pratikac/islom/README.md

islom
=====

Single legged hopping robot
