pratikac/islom/trunk/Doc/StageII/pres/design.tex

\section{Design}
\subsection*{Final Design}

\begin{frame}
\frametitle{Final Design}

\begin{columns}

\column{0.5\textwidth}
\begin{figure}
\centering
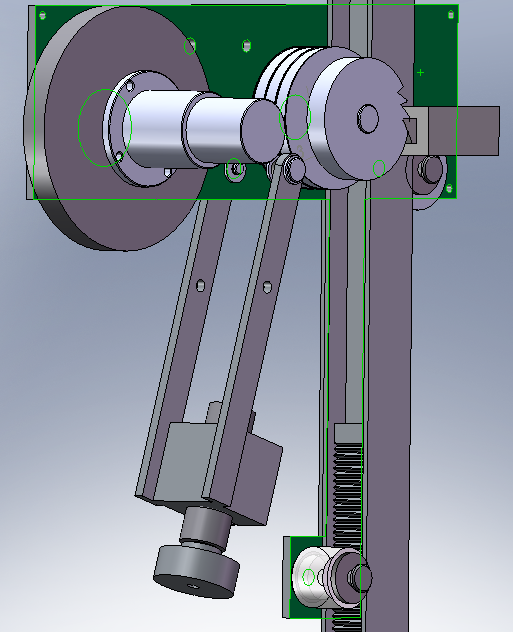
[picture p2: trunk/Doc/StageII/pres/fig/hopper_detach.png]

\caption{Detached motor sleeve}
\end{figure}

\column{0.5\textwidth}
\begin{block}{Features}
\begin{itemize}
\item
{\greencol EPM :}\\[0.1in]
    \begin{itemize}
    \item
    Motor travels down on rack\\[0.1in]
    \item
    Dual springs, helical gears and slant rack\\[0.1in]
    \end{itemize}
\item
{\greencol Constraint :}\\[0.1in]
    \begin{itemize}
    \item
    Ratchet and Paul\\[0.1in]
    \item
    Band drive\\[0.1in]
    \item
    Disengage motor sleeve\\[0.1in]
    \end{itemize}
\end{itemize}
\end{block}
\end{columns}
\end{frame}

\begin{frame}
\begin{columns}
\column{0.5\textwidth}
\begin{figure}
\centering

\caption{Detached motor sleeve}
\end{figure}

\column{0.5\textwidth}
\begin{figure}
\centering
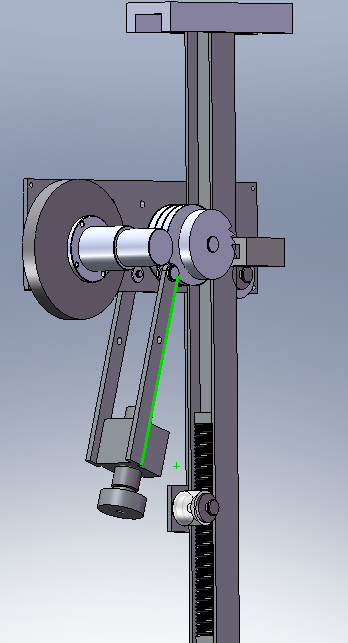
[picture p3: trunk/Doc/StageII/pres/fig/hopper_bot.png]

\caption{Full Robot}
\end{figure}
\end{columns}
\end{frame}

\begin{frame}
\frametitle{Final Design}
\begin{columns}

\column{0.5\textwidth}
\begin{figure}
\centering
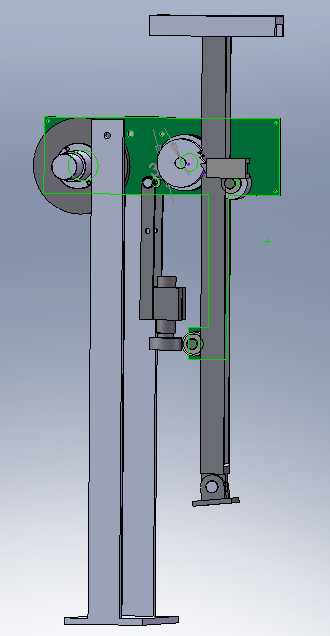
[picture p4: trunk/Doc/StageII/pres/fig/hopper_iso.png]

\caption{Test Rig}
\end{figure}

\column{0.5\textwidth}
\begin{block}{Features}
\begin{itemize}
\item
{\greencol Test-rig :}\\[0.1in]
    \begin{itemize}
    \item
    Pivoted near the C.G.\\[0.1in]
    \item
    Attitude re--orientation\\[0.1in]
    \item
    Simulated hopping\\[0.1in]
    \end{itemize}
\item
{\greencol Overall :}\\[0.1in]
    \begin{itemize}
    \item
    Height : $\sim$ 500 mm\\[0.1in]
    \item
    Leg $\sim$ 0.7 kg\\[0.1in]
    \item
    Total $\sim$ 4.7 kg\\[0.1in]
    \item
    Disengage motor sleeve\\[0.1in]
    \end{itemize}
\end{itemize}
\end{block}
\end{columns}
\end{frame}
