pratikac/islom/trunk/Doc/StageII/report/appendix.tex

{
\appendix
\chapter{Equations of motion}
\lstinputlisting{eqns.m}

\chapter{Kalman Filter Implementation}
\lstinputlisting{kalman_code.c}

}
