pratikac/islom/trunk/Doc/StageII/pres/conclu.tex

\section{Conclusion}

\begin{frame}
\frametitle{Summary}
\begin{block}{Fabrication}
\begin{itemize}
  \item 
  Robot fabrication almost done\\[0.1in]
  \item
  Electronics ready\\[0.1in]
\end{itemize} 
\end{block}\\[0.2in]

\begin{block}{Controller}
\begin{itemize}
  \item 
  In-place hopping solved\\[0.1in]
  \item
  More work on trajectory following\\[0.1in]
\end{itemize} 
\end{block}\\[0.2in]

\begin{block}{Future Work}
\begin{itemize}
  \item 
  Assisted test-rig control\\[0.1in]
  \item
  Running on treadmill
\end{itemize} 
\end{block}
\end{frame}
