pratikac/islom/trunk/Doc/StageII/report/fig/line_sketch.pdf

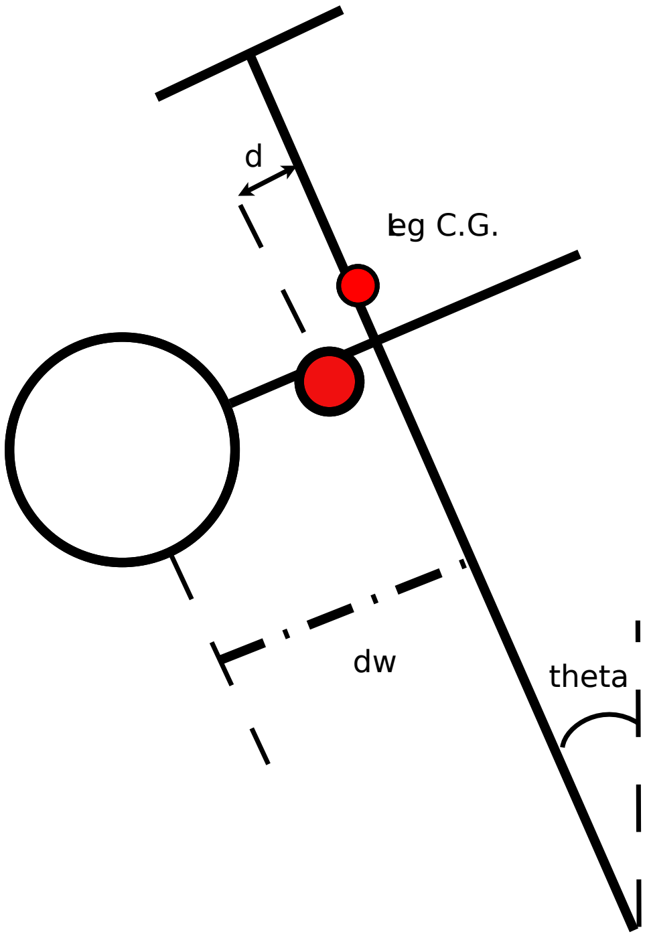
[picture p40: figure]
theta; Leg C.G.
