pratikac/islom/trunk/Doc/StageI/report/fig/freq_m.pdf

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

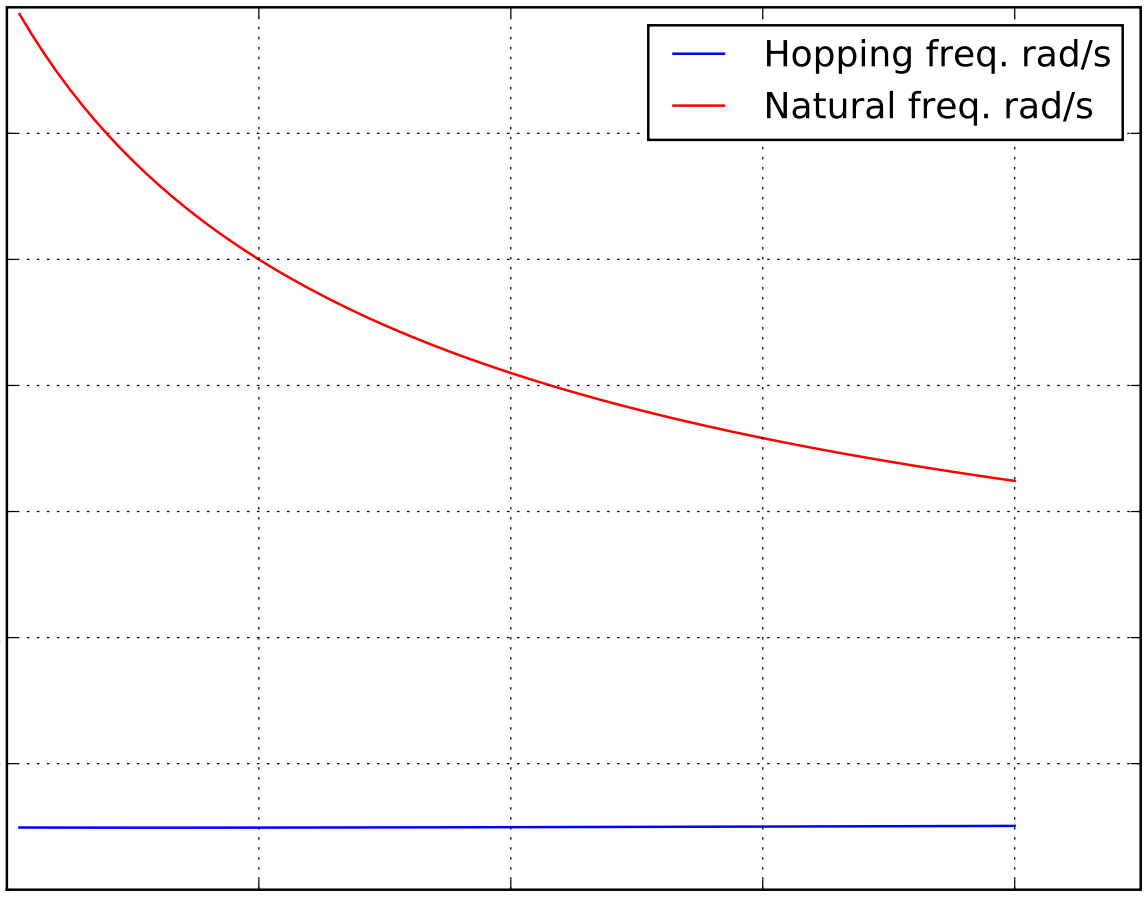
[picture p41: figure]
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
