pratikac/islom/trunk/Doc/StageI/report/fig/Rai_2D.pdf

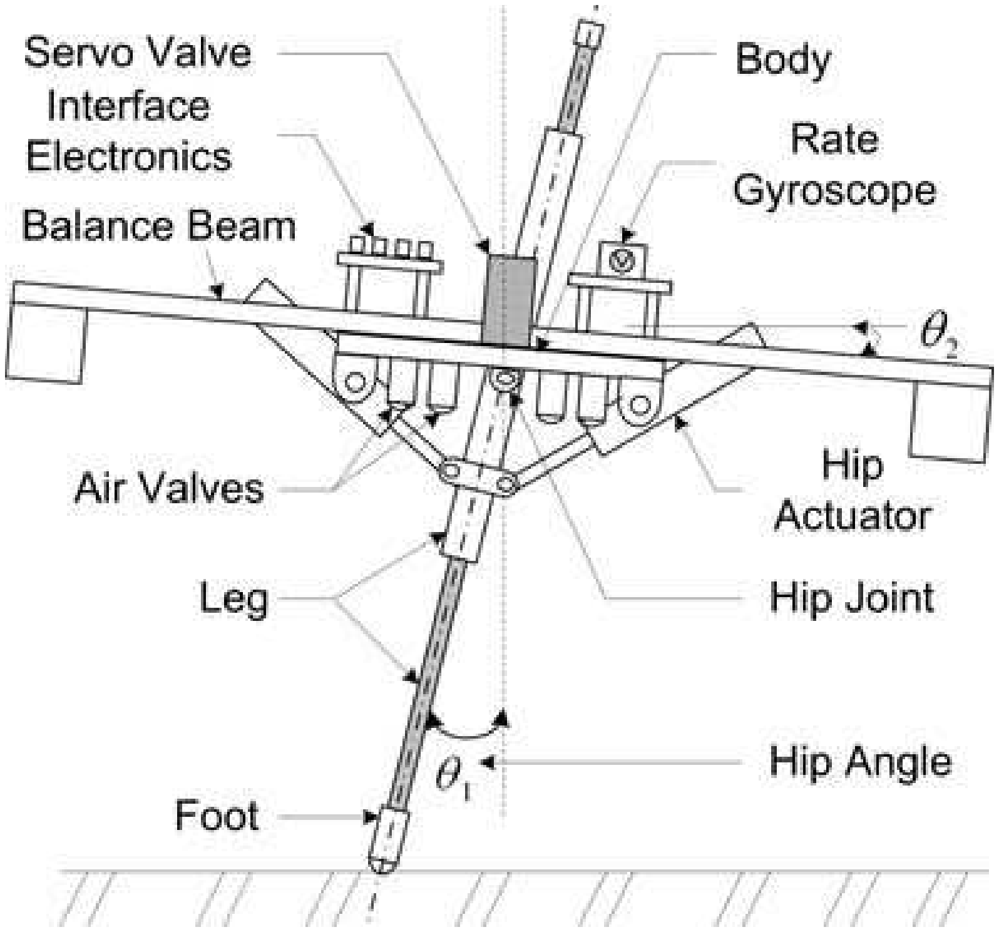
[picture p42: page 1]
