pratikac/islom/trunk/Doc/StageI/report/fig/Rai_3D.pdf

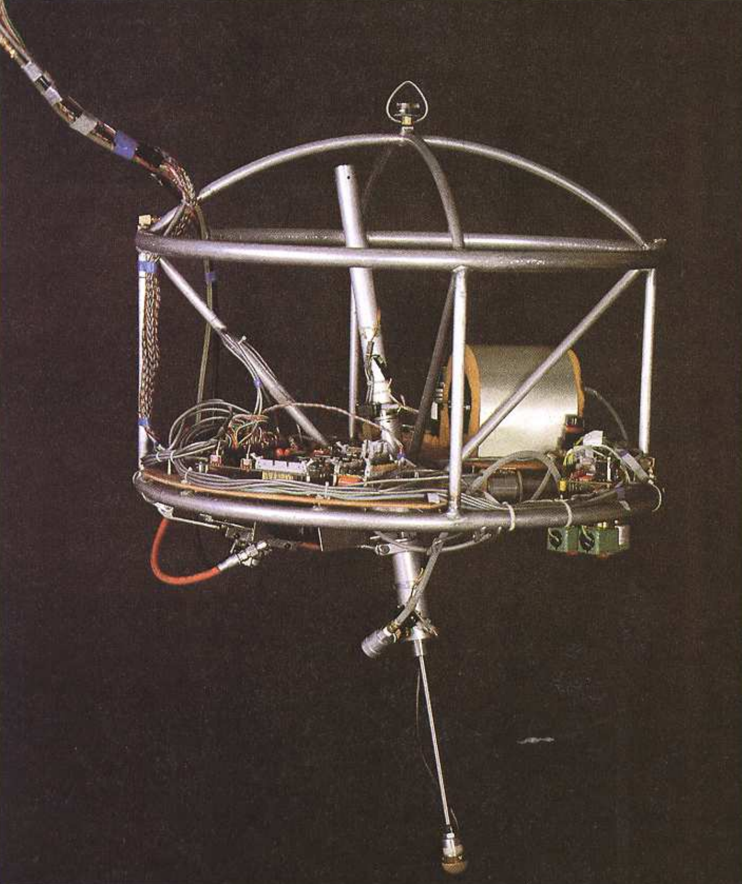
[picture p43: page 1]
