pratikac/islom/trunk/Doc/StageII/report/fig/atanD.pdf

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

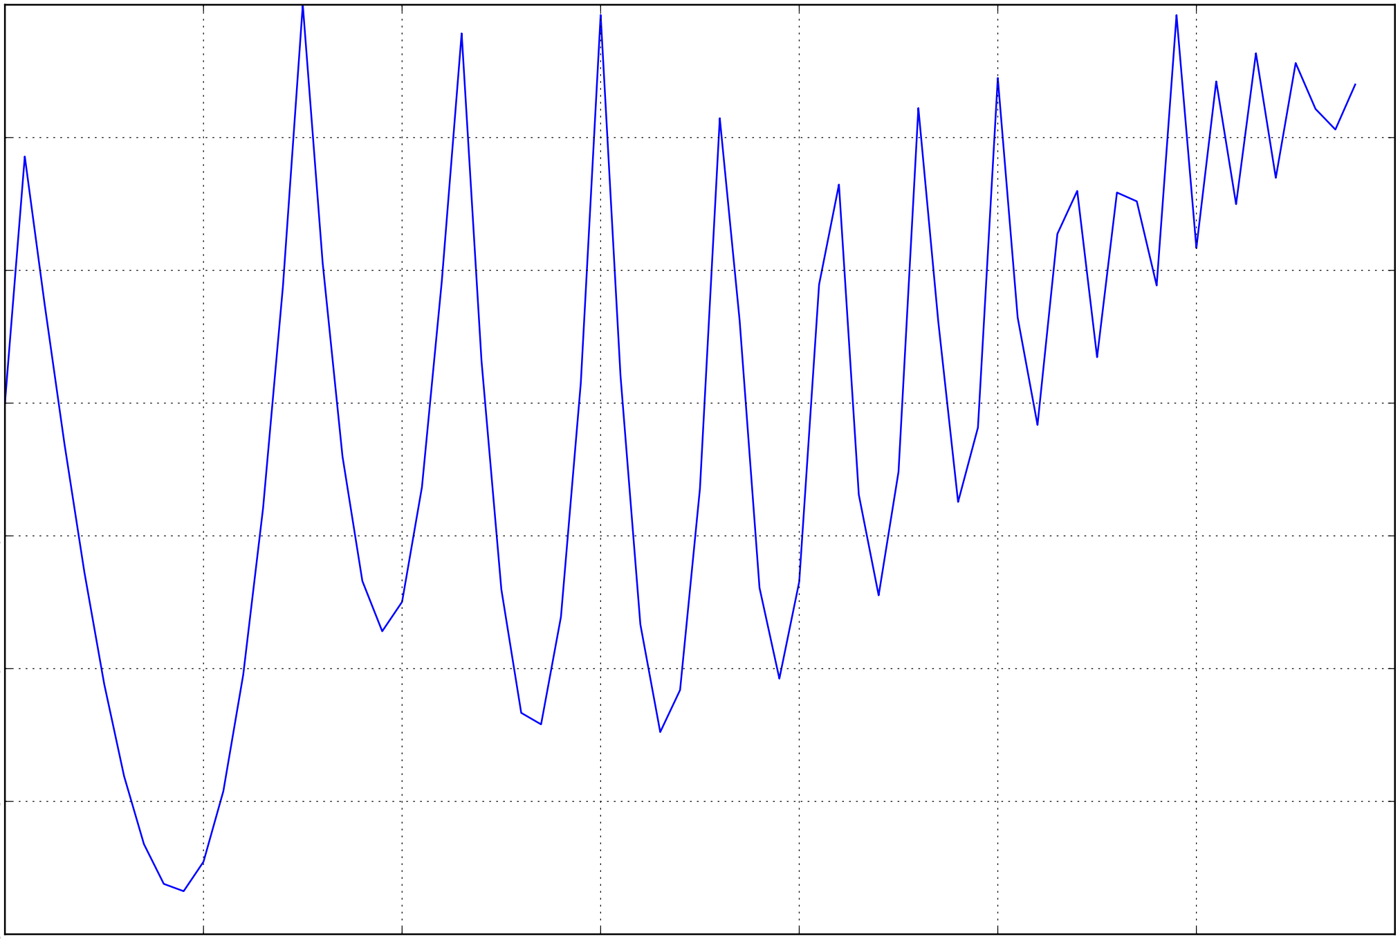
[picture p44: figure]
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
