pratikac/islom/trunk/Doc/StageI/pres/fig/cartoon.png

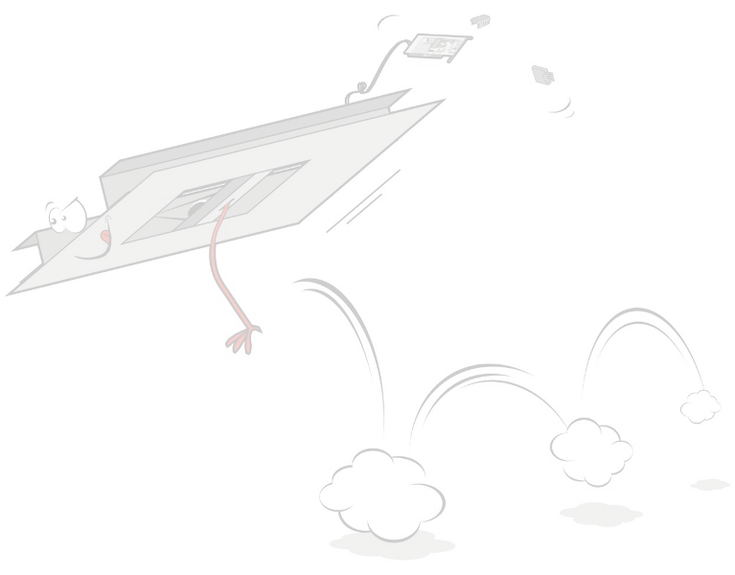
trunk/Doc/StageI/pres/fig/cartoon.png
