pratikac/islom/trunk/SolidWorks/gear_pulley.png

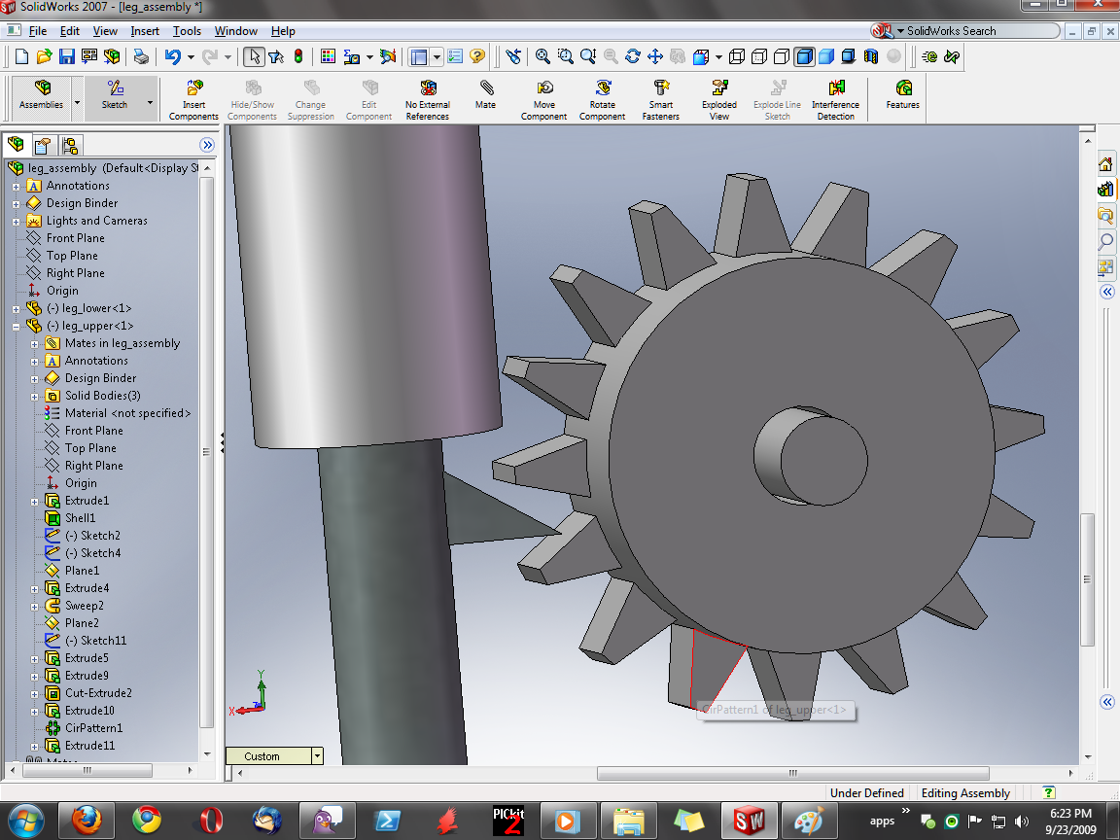
trunk/SolidWorks/gear_pulley.png
