pratikac/islom/trunk/SolidWorks/leg_assembly.SLDASM

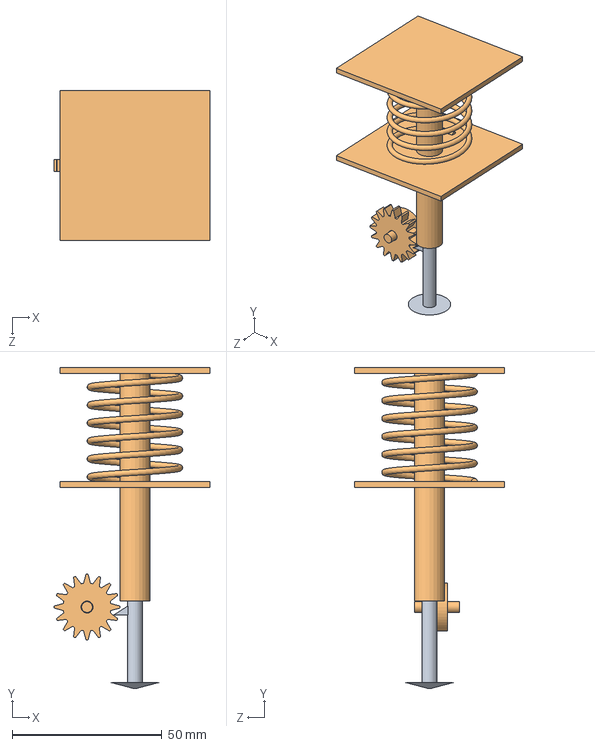
[picture p47: CAD file, 2013-02-24]
trunk/SolidWorks/leg_assembly.SLDASM
52.0 x 107.2 x 50.0 mm
leg_lower
leg_upper
