pratikac/islom/trunk/SolidWorks/fab3/platform.SLDASM

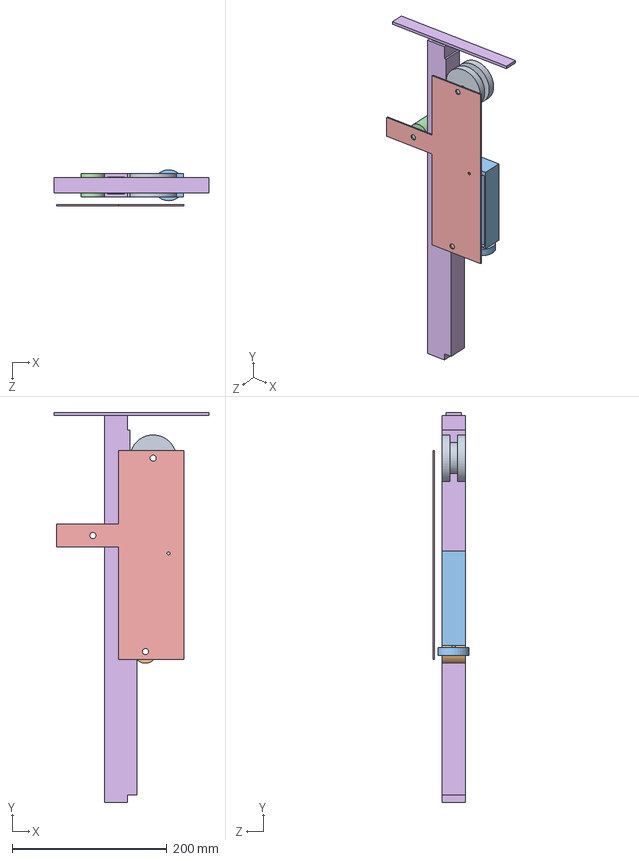
[picture p48: CAD file, 2013-02-24]
trunk/SolidWorks/fab3/platform.SLDASM
200.0 x 504.0 x 47.0 mm
band_drive
worm_wheel
motor
support_wheel
flange1
leg
