pratikac/islom/trunk/SolidWorks/Bouncebot/Bouncebot assy.SLDASM

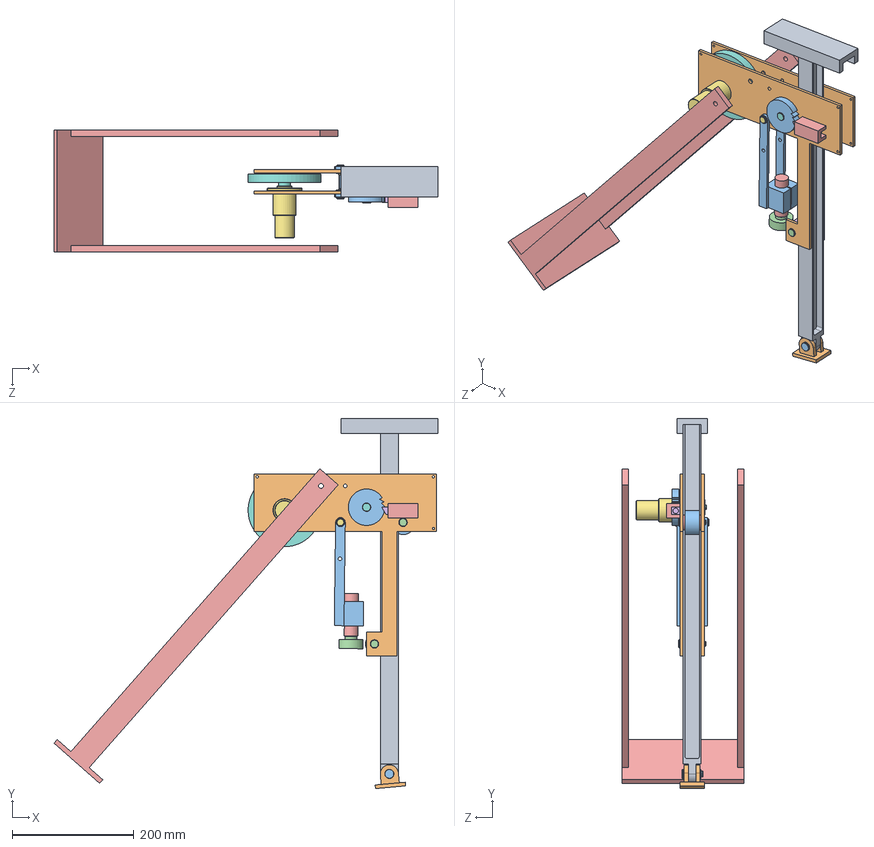
[picture p49: CAD file, 2013-02-24]
trunk/SolidWorks/Bouncebot/Bouncebot assy.SLDASM
631.8 x 609.2 x 200.0 mm
01 Stem
02 Rack
03 Swing
05 Swing Motor Gear
04 Swing Motor
06 Helical Pinion
12 Swing Pin x 2
11 Swing Pin Washer x 4
10 Swing Bush x 2
09 Slider Body x 2
13 Support Roll
08 Pinion Axle x 2
07 Pinion Spacer x 4
14 Lock Roll
18 Lock Roll Spacer x 2
19 Ratchet Pivot
16 Ratchet Key
17 Ratchet Spacer x 2
20 Ratchet
15 Lock Roll Key
22 Pawl Guide
21 Pawl
23 Rudder Roll Motor
24 Rudder Roll
25 Top Stopper
26 Stem Pivot Base
27 Stem Pivot Pin
28 Stem Pivot Spacer x 2
29 Test Stand
