pratikac/islom/trunk/SolidWorks/fab3/band_drive.SLDPRT

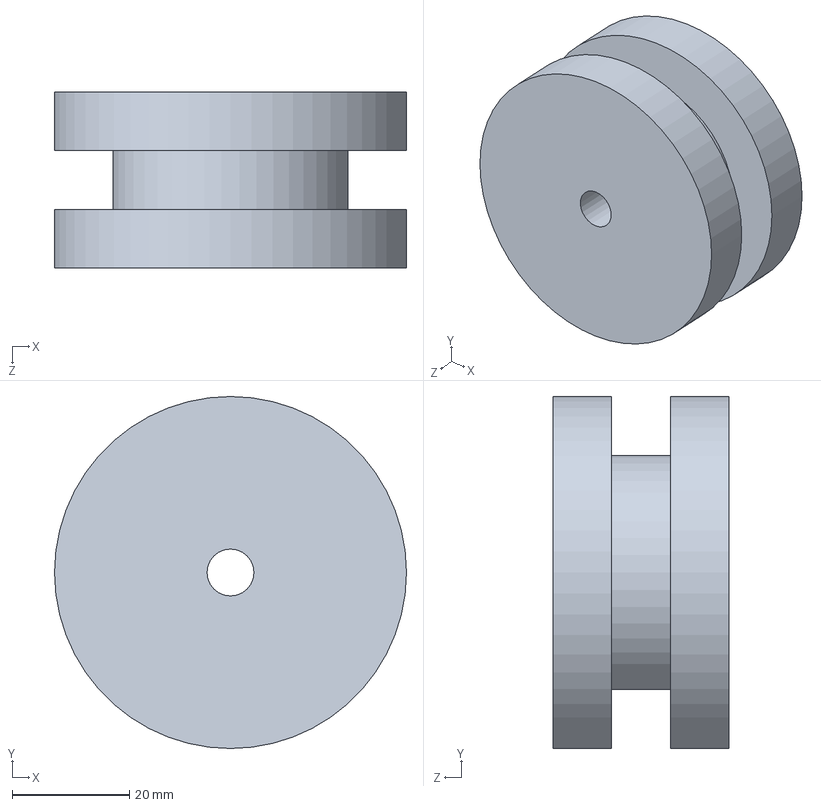
[picture p50: CAD file, 2013-02-24]
trunk/SolidWorks/fab3/band_drive.SLDPRT
60.0 x 60.0 x 30.0 mm
