pratikac/islom/trunk/SolidWorks/leg_lower.SLDPRT

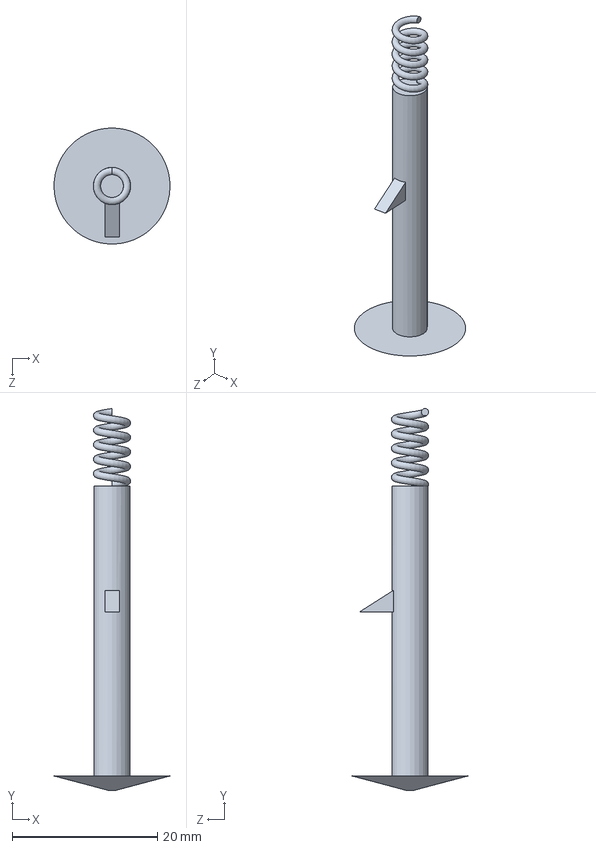
[picture p51: CAD file, 2013-02-24]
trunk/SolidWorks/leg_lower.SLDPRT
16.0 x 52.7 x 16.0 mm
