pratikac/islom/trunk/SolidWorks/Bouncebot/02 Rack.SLDPRT

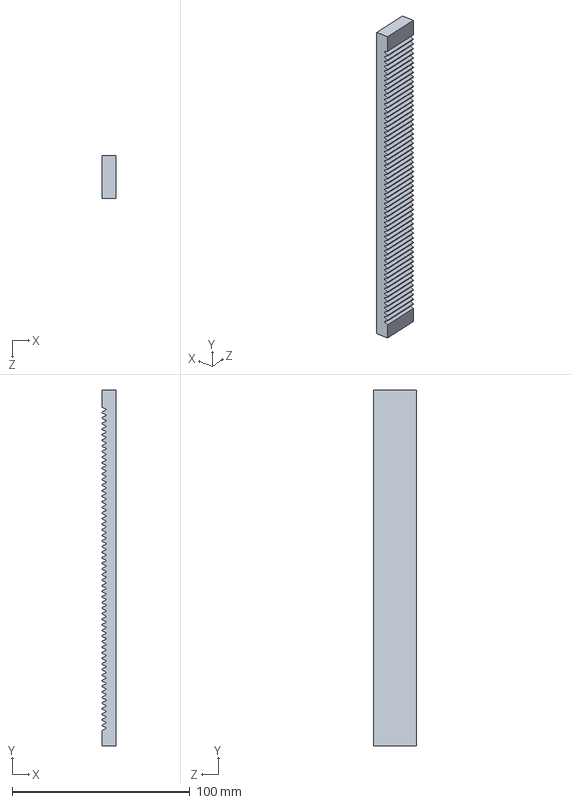
[picture p52: CAD file, 2013-02-24]
trunk/SolidWorks/Bouncebot/02 Rack.SLDPRT
8.00 x 200.0 x 24.0 mm
