pratikac/islom/trunk/SolidWorks/fab3/support_wheel.SLDPRT

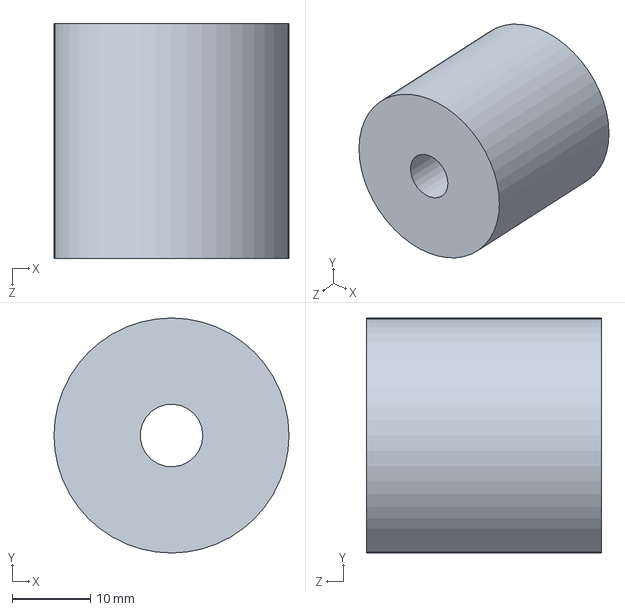
[picture p53: CAD file, 2013-02-24]
trunk/SolidWorks/fab3/support_wheel.SLDPRT
30.0 x 30.0 x 30.0 mm
