pratikac/islom/trunk/SolidWorks/fab_leg.SLDPRT

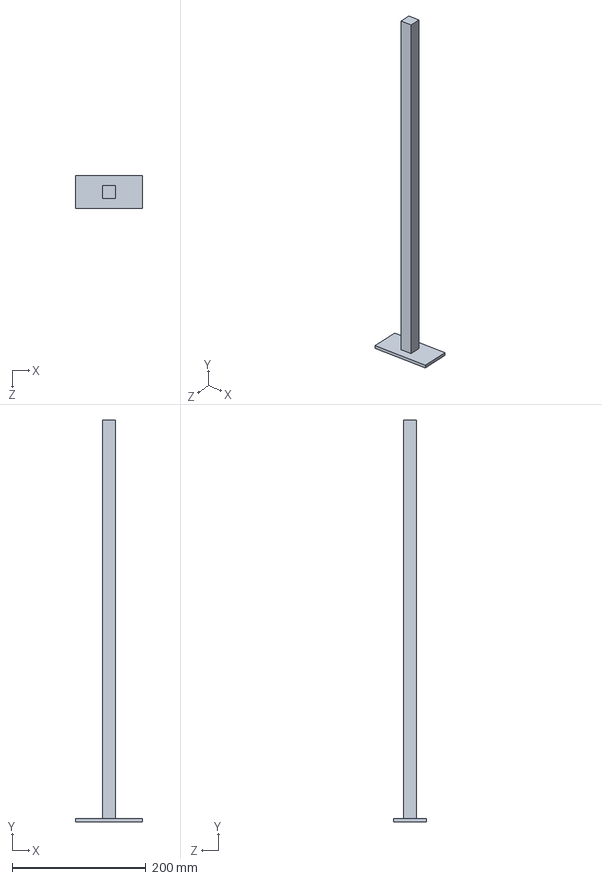
[picture p54: CAD file, 2013-02-24]
trunk/SolidWorks/fab_leg.SLDPRT
100.0 x 600.0 x 50.0 mm
