pratikac/islom/trunk/SolidWorks/Bouncebot/24 Rudder Roll.SLDPRT

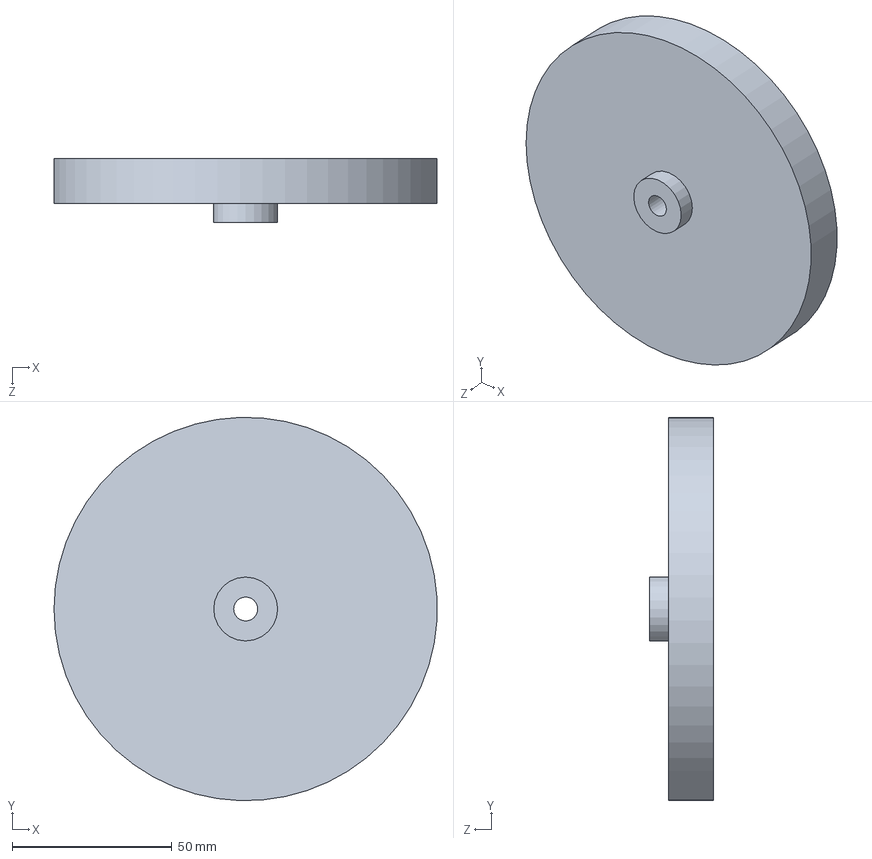
[picture p55: CAD file, 2013-02-24]
trunk/SolidWorks/Bouncebot/24 Rudder Roll.SLDPRT
119.9 x 119.9 x 20.0 mm
