pratikac/islom/trunk/SolidWorks/fab3/pin2.SLDPRT

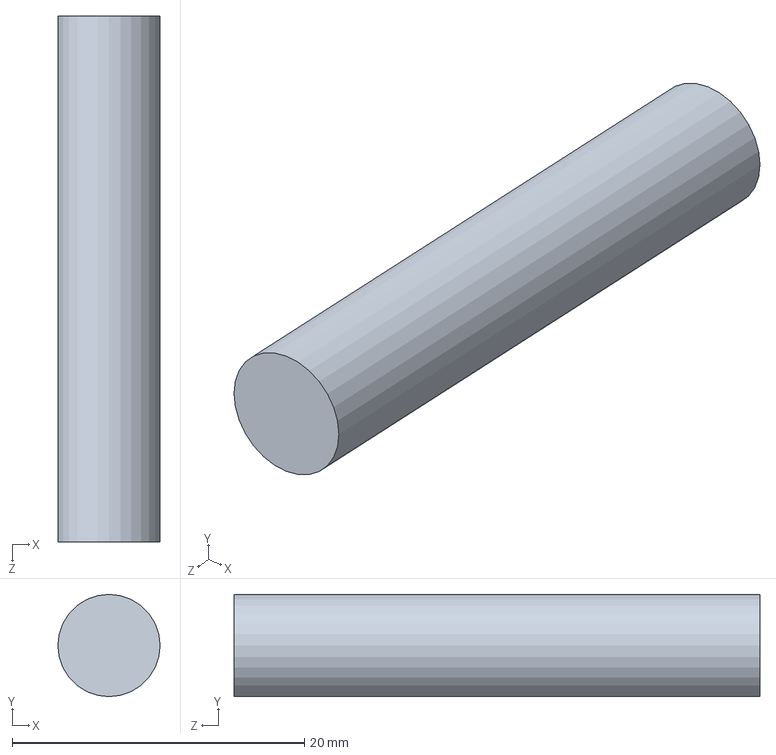
[picture p56: CAD file, 2013-02-24]
trunk/SolidWorks/fab3/pin2.SLDPRT
7.00 x 7.00 x 36.0 mm
