pratikac/islom/trunk/SolidWorks/Bouncebot/03 Swing.SLDPRT

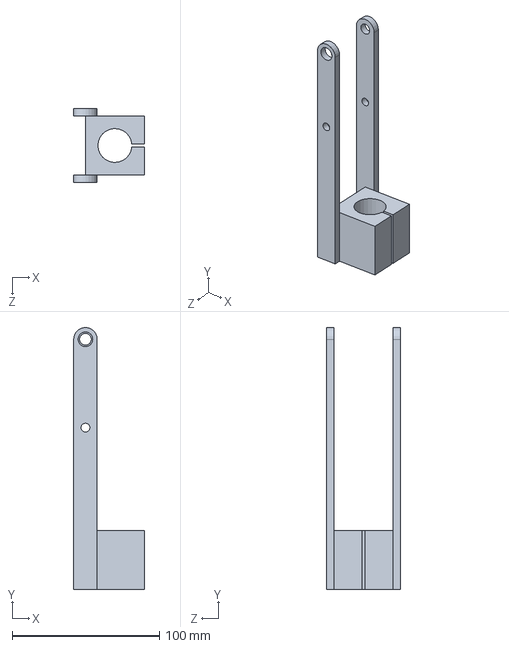
[picture p57: CAD file, 2013-02-24]
trunk/SolidWorks/Bouncebot/03 Swing.SLDPRT
48.0 x 178.0 x 50.0 mm
