pratikac/islom/trunk/SolidWorks/fab3/flange2.SLDPRT

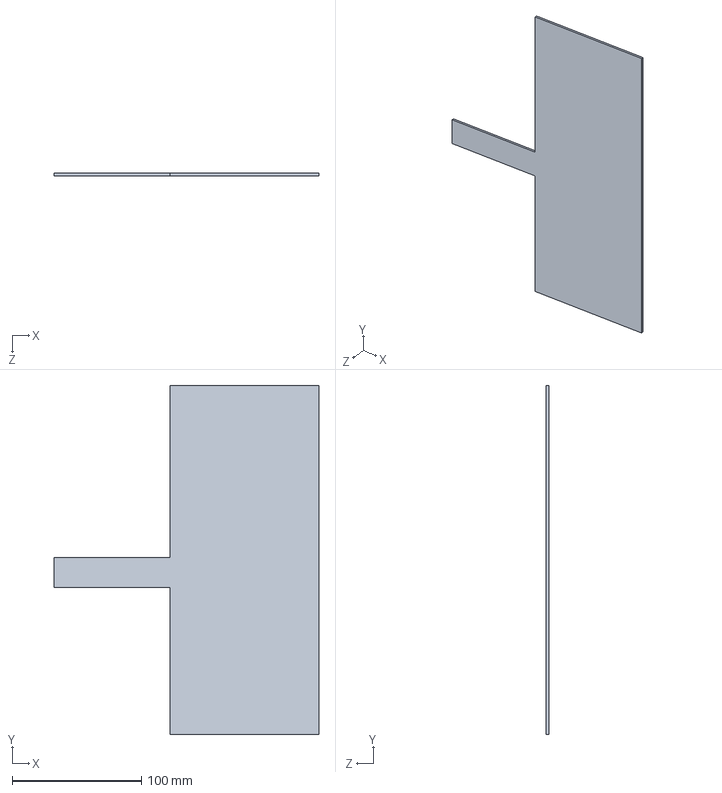
[picture p58: CAD file, 2013-02-24]
trunk/SolidWorks/fab3/flange2.SLDPRT
204.8 x 270.0 x 2.00 mm
