pratikac/islom/trunk/SolidWorks/leg_upper.SLDPRT

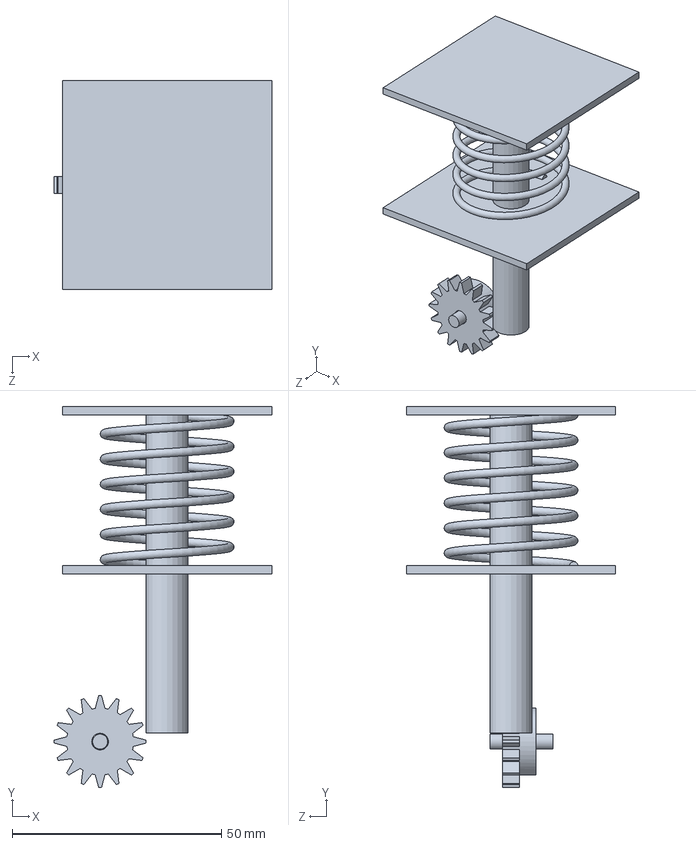
[picture p59: CAD file, 2013-02-24]
trunk/SolidWorks/leg_upper.SLDPRT
52.0 x 91.0 x 50.0 mm
