pratikac/islom/trunk/SolidWorks/Bouncebot/19 Ratchet Pivot.SLDPRT

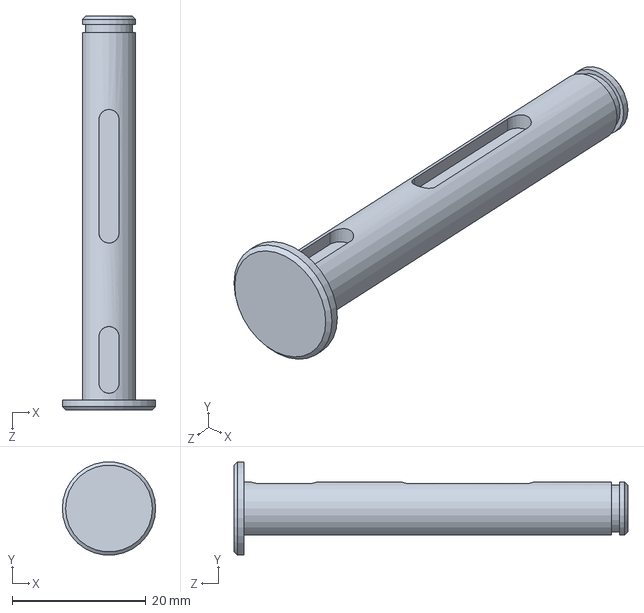
[picture p60: CAD file, 2013-02-24]
trunk/SolidWorks/Bouncebot/19 Ratchet Pivot.SLDPRT
14.0 x 13.9 x 59.0 mm
