pratikac/islom/trunk/SolidWorks/Bouncebot/29 Test Stand.SLDPRT

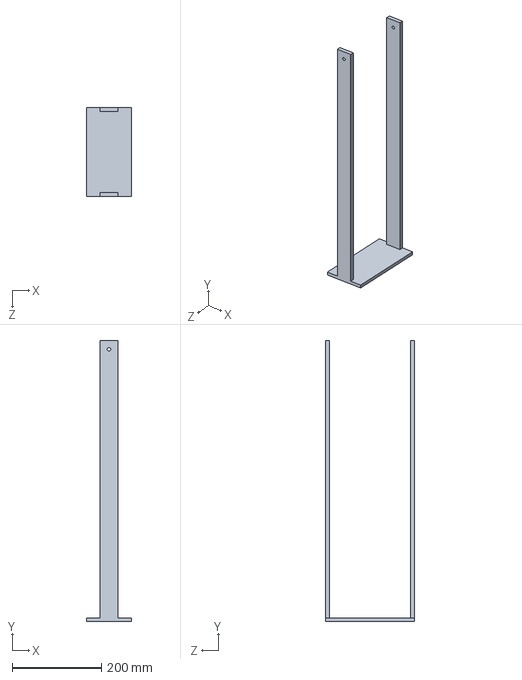
[picture p61: CAD file, 2013-02-24]
trunk/SolidWorks/Bouncebot/29 Test Stand.SLDPRT
100.0 x 628.0 x 200.0 mm
