pratikac/islom/trunk/SolidWorks/Bouncebot/25 Top Stopper.SLDPRT

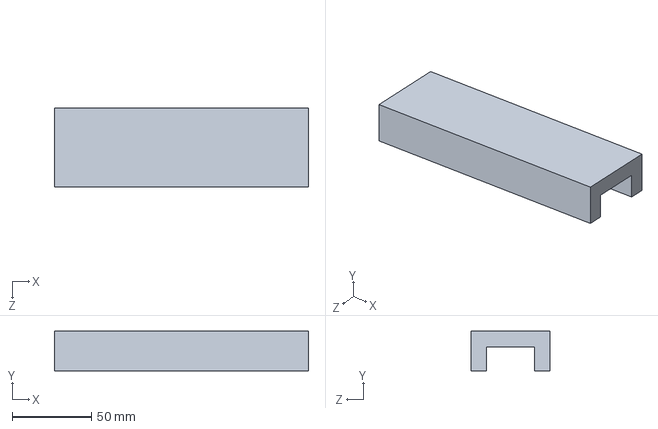
[picture p62: CAD file, 2013-02-24]
trunk/SolidWorks/Bouncebot/25 Top Stopper.SLDPRT
160.0 x 25.0 x 50.0 mm
