pratikac/islom/trunk/SolidWorks/fab3/motor.SLDPRT

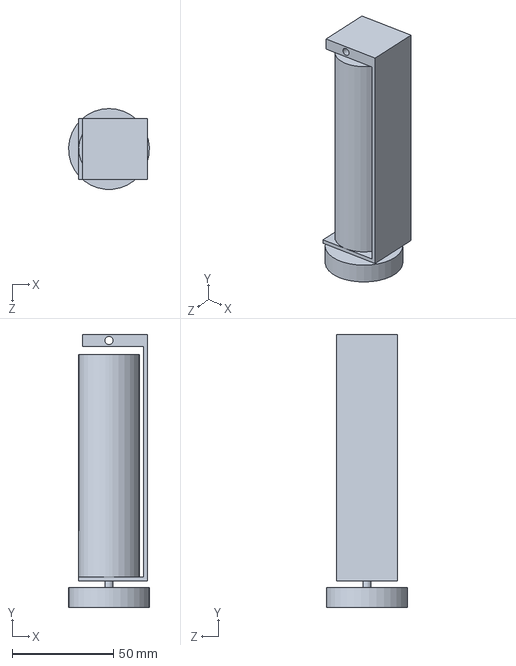
[picture p63: CAD file, 2013-02-24]
trunk/SolidWorks/fab3/motor.SLDPRT
40.0 x 135.0 x 40.0 mm
