pratikac/islom/trunk/SolidWorks/Bouncebot/04 Swing Motor.SLDPRT

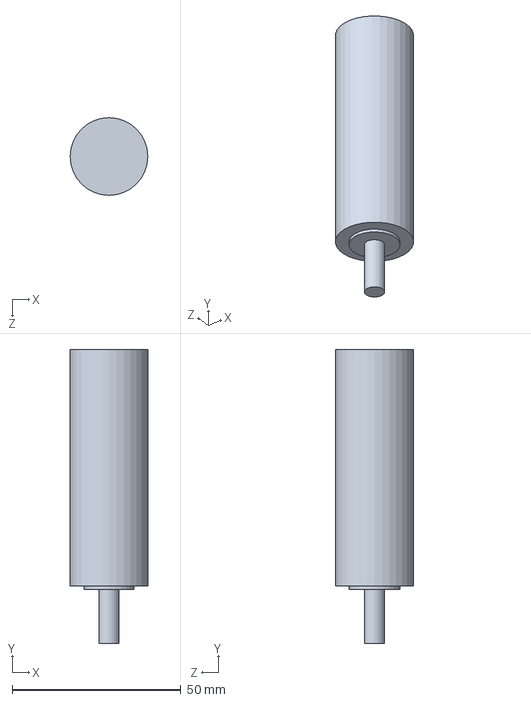
[picture p64: CAD file, 2013-02-24]
trunk/SolidWorks/Bouncebot/04 Swing Motor.SLDPRT
23.0 x 87.0 x 23.0 mm
