pratikac/islom/trunk/SolidWorks/Bouncebot/17 Ratchet Spacer.SLDPRT

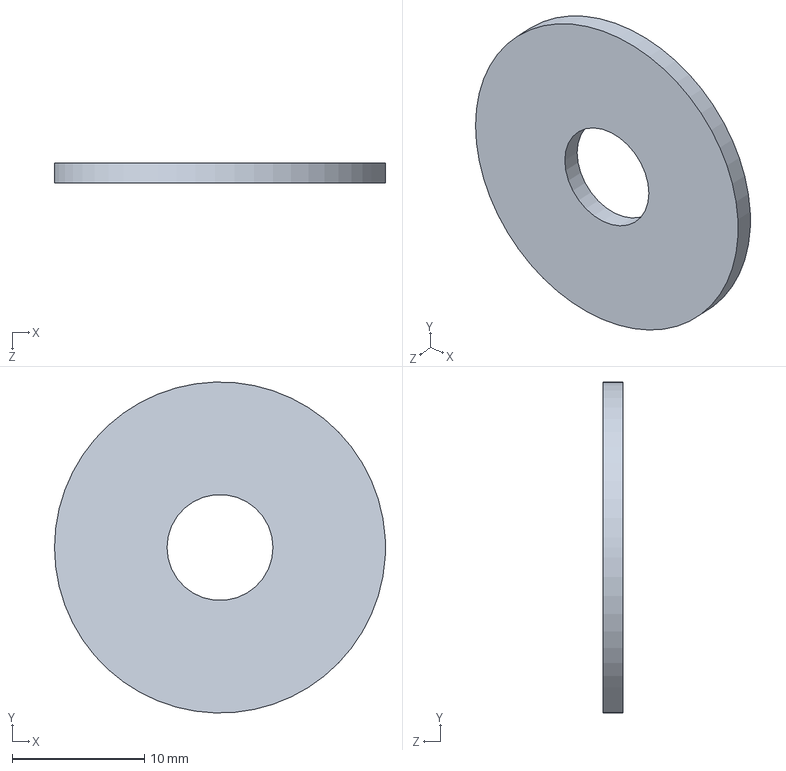
[picture p65: CAD file, 2013-02-24]
trunk/SolidWorks/Bouncebot/17 Ratchet Spacer.SLDPRT
25.0 x 25.0 x 1.50 mm
