pratikac/islom/trunk/SolidWorks/Bouncebot/26 Stem Pivot Base.SLDPRT

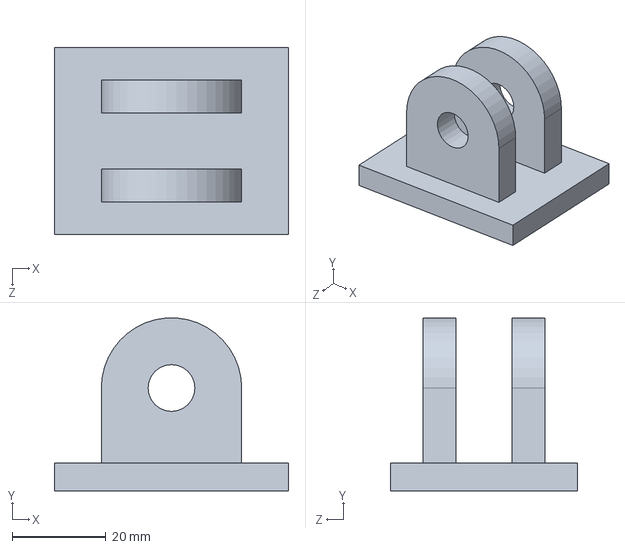
[picture p66: CAD file, 2013-02-24]
trunk/SolidWorks/Bouncebot/26 Stem Pivot Base.SLDPRT
50.0 x 37.0 x 40.0 mm
