pratikac/islom/trunk/SolidWorks/Bouncebot/22 Pawl Guide.SLDPRT

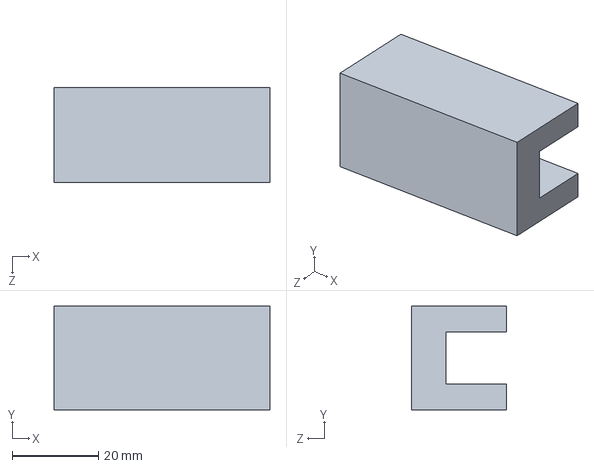
[picture p67: CAD file, 2013-02-24]
trunk/SolidWorks/Bouncebot/22 Pawl Guide.SLDPRT
50.0 x 24.0 x 22.0 mm
