pratikac/islom/trunk/SolidWorks/fab3/leg.SLDPRT

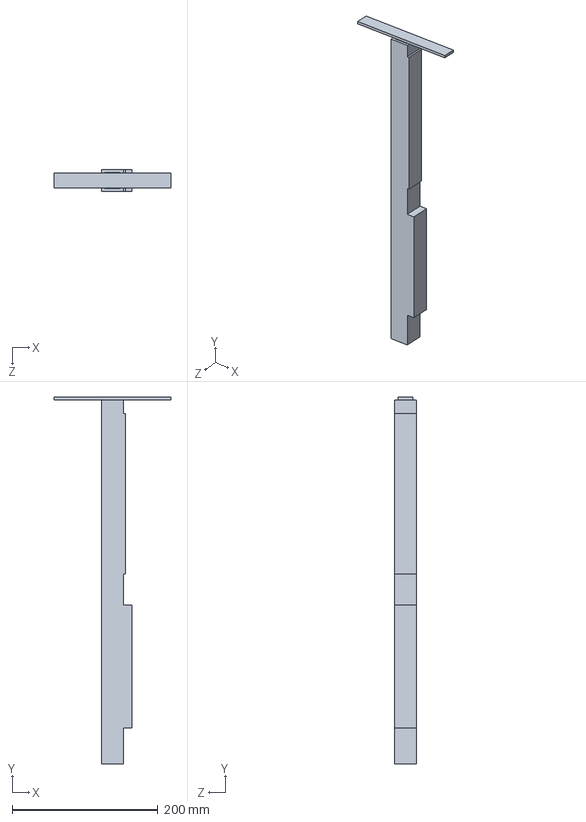
[picture p68: CAD file, 2013-02-24]
trunk/SolidWorks/fab3/leg.SLDPRT
160.0 x 504.0 x 30.0 mm
