pratikac/islom/trunk/SolidWorks/Bouncebot/28 Stem Pivot Spacer.SLDPRT

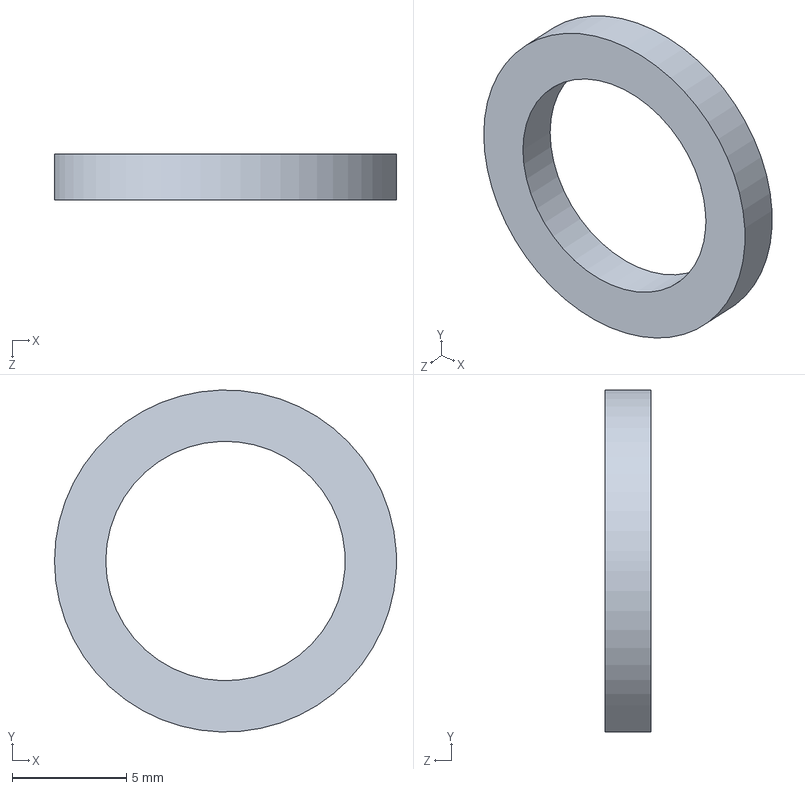
[picture p69: CAD file, 2013-02-24]
trunk/SolidWorks/Bouncebot/28 Stem Pivot Spacer.SLDPRT
15.0 x 15.0 x 2.00 mm
