pratikac/islom/trunk/SolidWorks/Bouncebot/05 Swing Motor Gear.SLDPRT

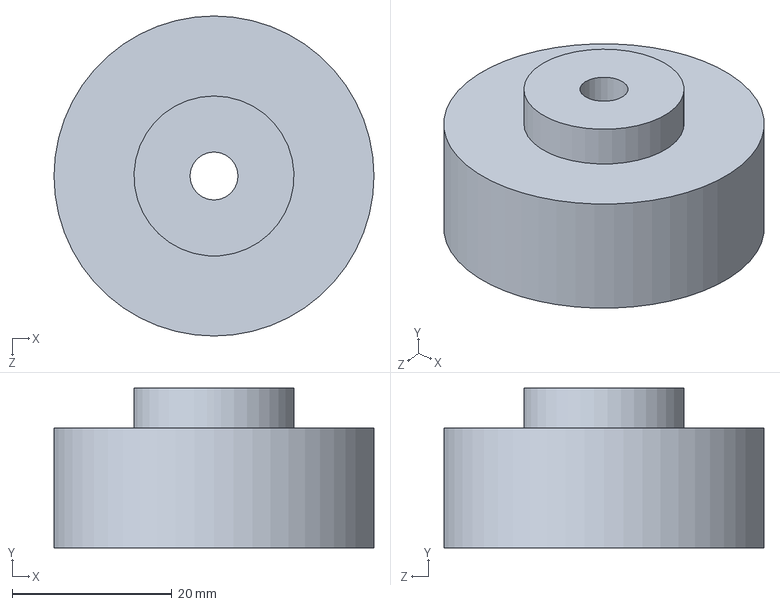
[picture p70: CAD file, 2013-02-24]
trunk/SolidWorks/Bouncebot/05 Swing Motor Gear.SLDPRT
40.0 x 20.0 x 40.0 mm
