pratikac/islom/trunk/SolidWorks/Bouncebot/16 Ratchet Key.SLDPRT

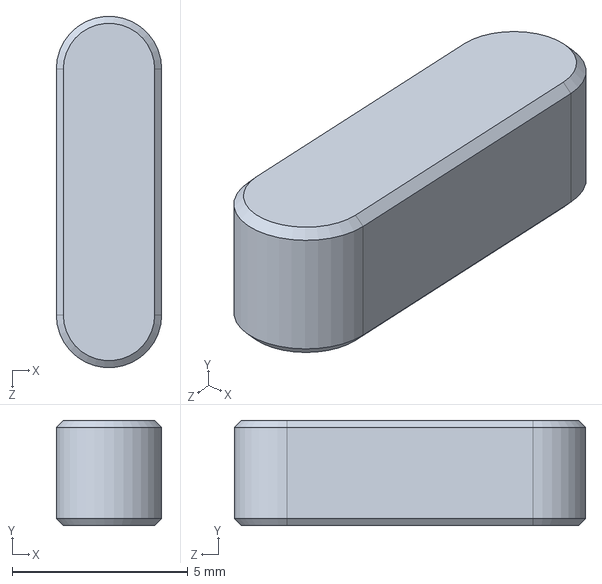
[picture p71: CAD file, 2013-02-24]
trunk/SolidWorks/Bouncebot/16 Ratchet Key.SLDPRT
3.00 x 3.00 x 9.99 mm
