pratikac/islom/trunk/SolidWorks/Bouncebot/14 Lock Roll.SLDPRT

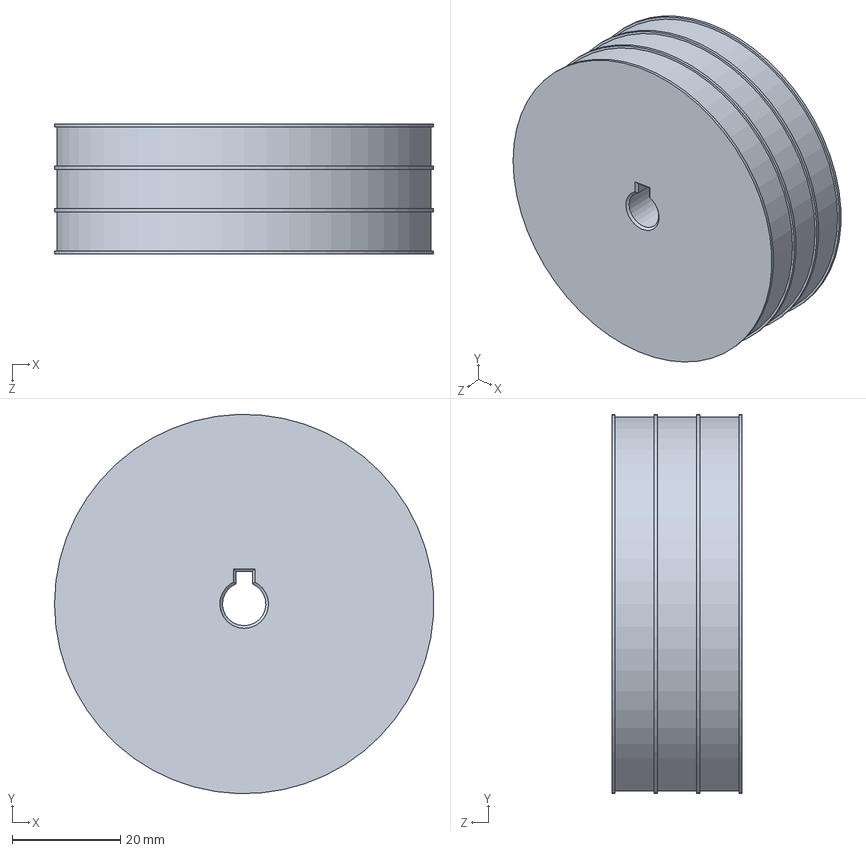
[picture p72: CAD file, 2013-02-24]
trunk/SolidWorks/Bouncebot/14 Lock Roll.SLDPRT
69.9 x 70.0 x 24.0 mm
