pratikac/islom/trunk/SolidWorks/Bouncebot/13 Support Roll.SLDPRT

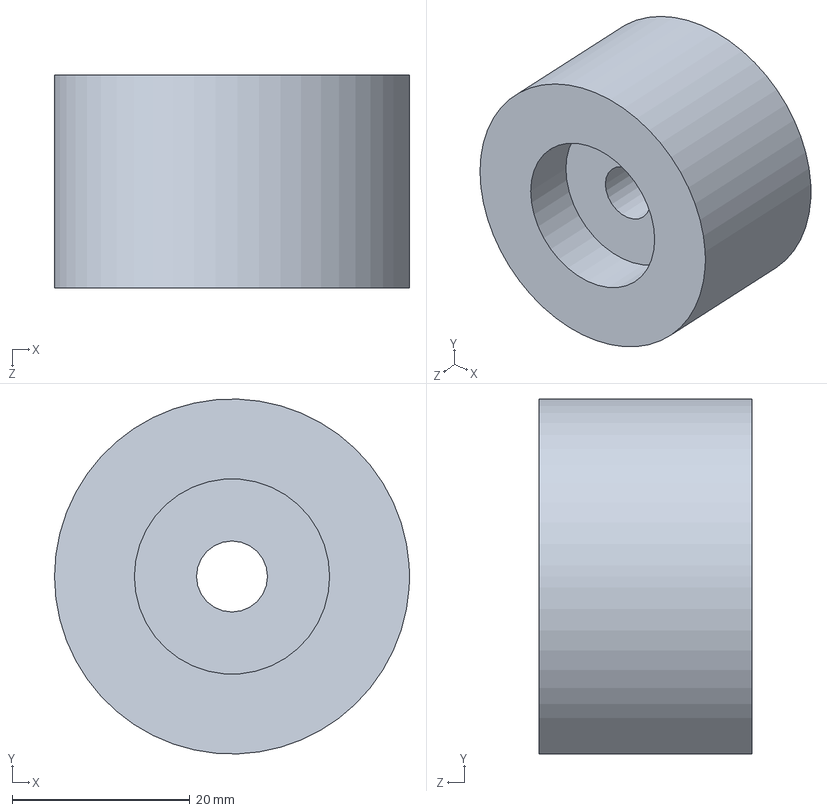
[picture p73: CAD file, 2013-02-24]
trunk/SolidWorks/Bouncebot/13 Support Roll.SLDPRT
40.0 x 40.0 x 24.0 mm
