pratikac/islom/trunk/SolidWorks/Bouncebot/15 Lock Roll Key.SLDPRT

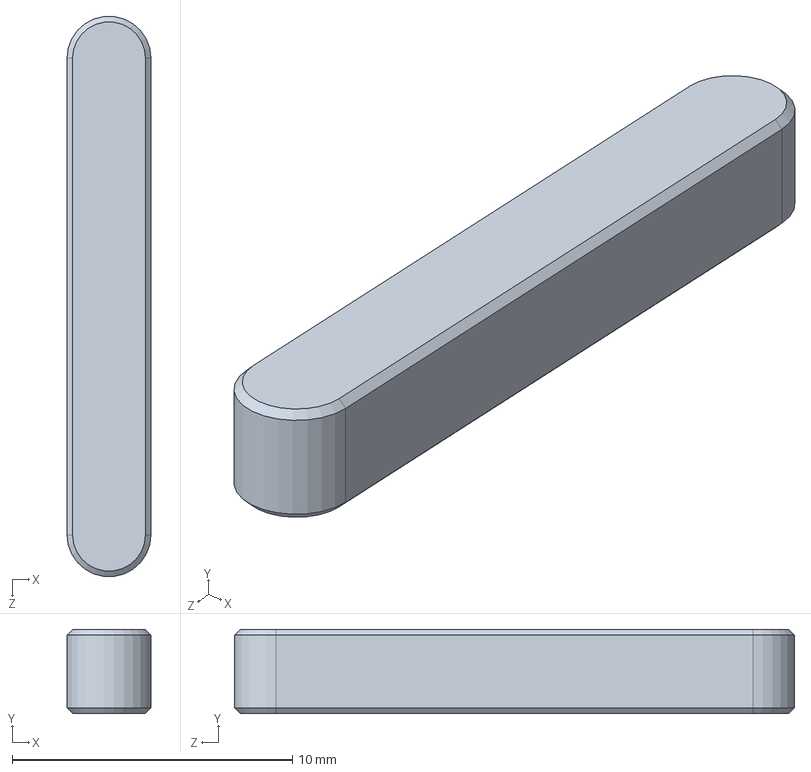
[picture p74: CAD file, 2013-02-24]
trunk/SolidWorks/Bouncebot/15 Lock Roll Key.SLDPRT
3.00 x 3.00 x 20.0 mm
