pratikac/islom/trunk/SolidWorks/Bouncebot/09 Slider Body.SLDPRT

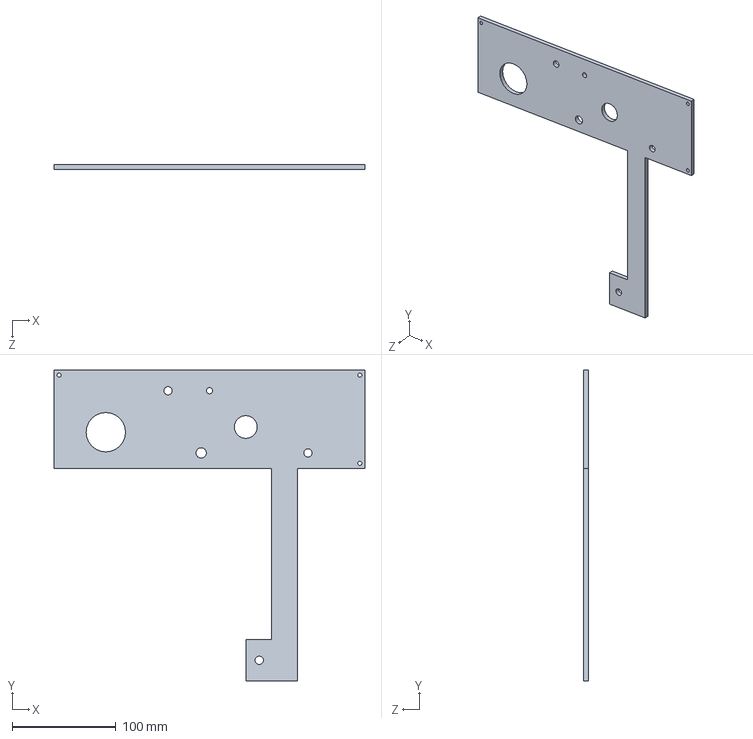
[picture p75: CAD file, 2013-02-24]
trunk/SolidWorks/Bouncebot/09 Slider Body.SLDPRT
300.0 x 300.0 x 5.00 mm
