pratikac/islom/trunk/SolidWorks/Bouncebot/06 Helical Pinion.SLDPRT

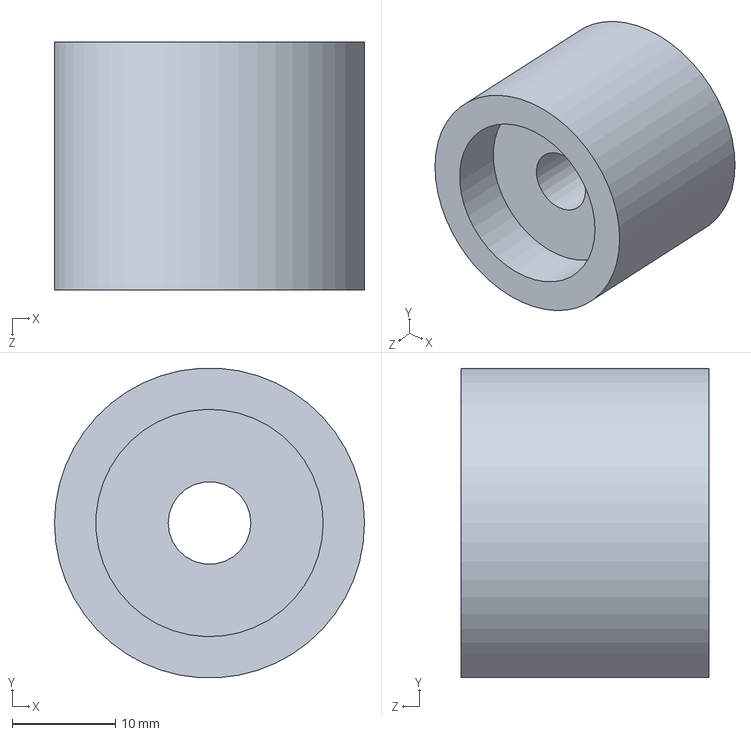
[picture p76: CAD file, 2013-02-24]
trunk/SolidWorks/Bouncebot/06 Helical Pinion.SLDPRT
30.0 x 29.9 x 24.0 mm
