pratikac/islom/trunk/SolidWorks/Bouncebot/08 Pinion Axle.SLDPRT

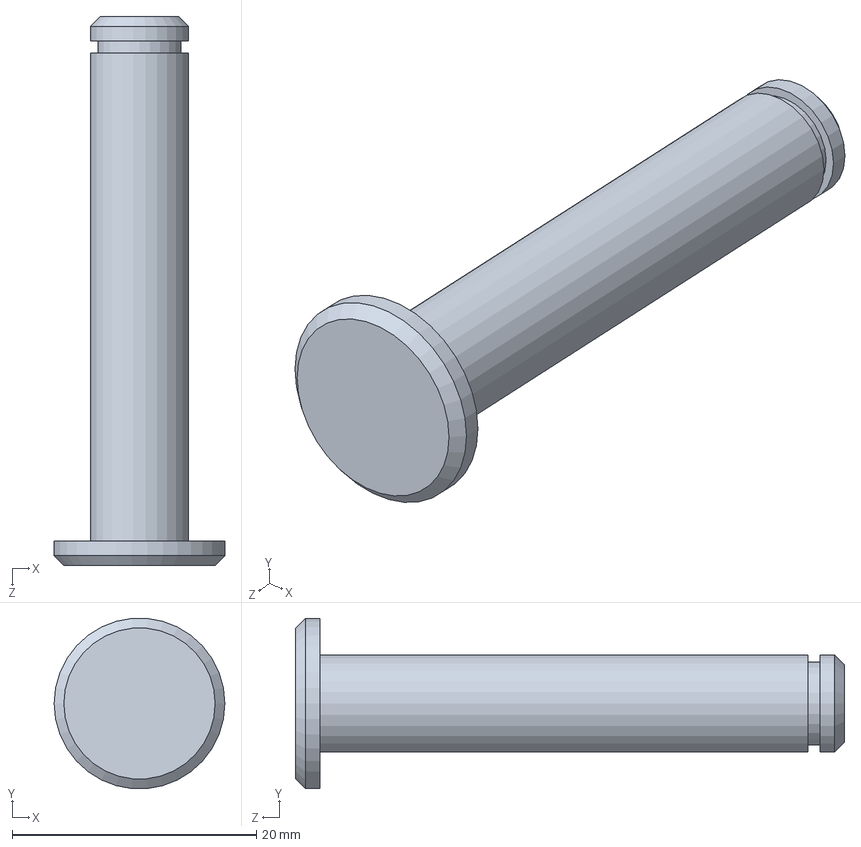
[picture p77: CAD file, 2013-02-24]
trunk/SolidWorks/Bouncebot/08 Pinion Axle.SLDPRT
14.0 x 13.9 x 45.0 mm
