pratikac/islom/trunk/SolidWorks/Bouncebot/20 Ratchet.SLDPRT

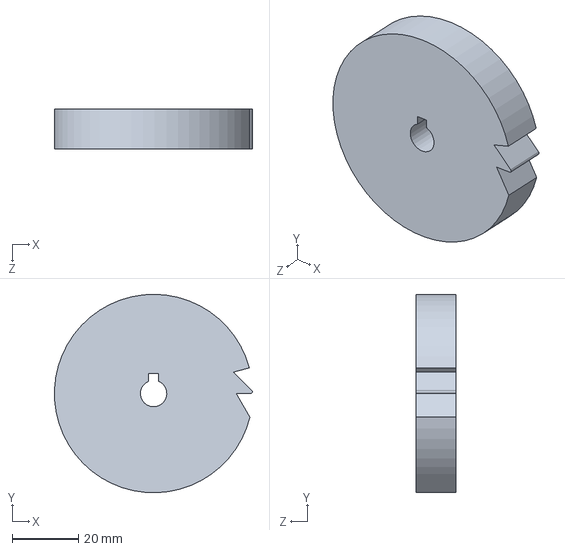
[picture p78: CAD file, 2013-02-24]
trunk/SolidWorks/Bouncebot/20 Ratchet.SLDPRT
59.9 x 60.0 x 12.0 mm
