pratikac/islom/trunk/SolidWorks/Bouncebot/21 Pawl.SLDPRT

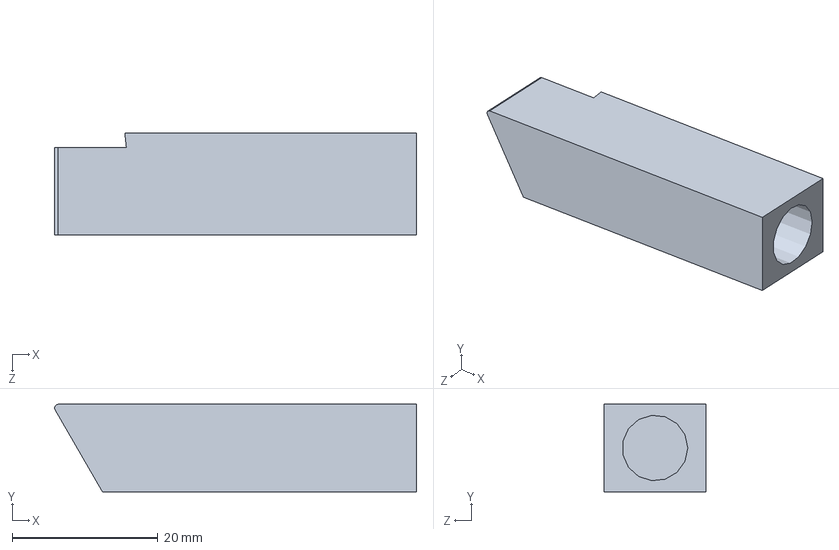
[picture p79: CAD file, 2013-02-24]
trunk/SolidWorks/Bouncebot/21 Pawl.SLDPRT
49.6 x 12.0 x 14.0 mm
