pratikac/islom/trunk/SolidWorks/Bouncebot/10 Swing Bush.SLDPRT

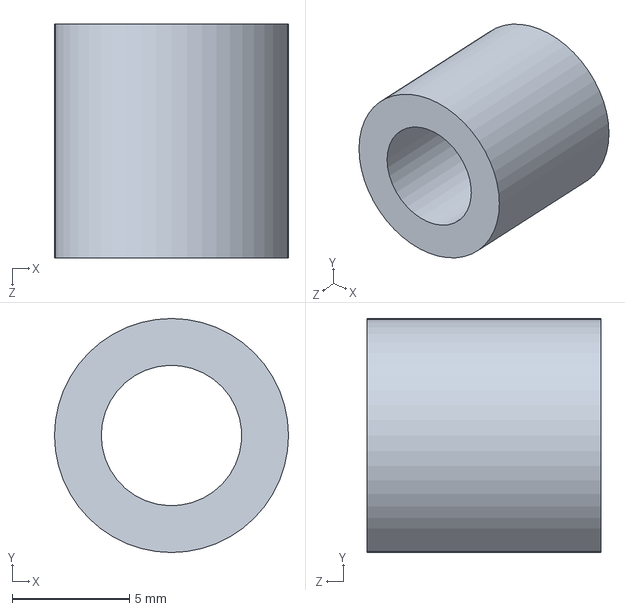
[picture p80: CAD file, 2013-02-24]
trunk/SolidWorks/Bouncebot/10 Swing Bush.SLDPRT
10.0 x 10.0 x 10.0 mm
