pratikac/islom/trunk/SolidWorks/Bouncebot/23 Rudder Roll Motor.SLDPRT

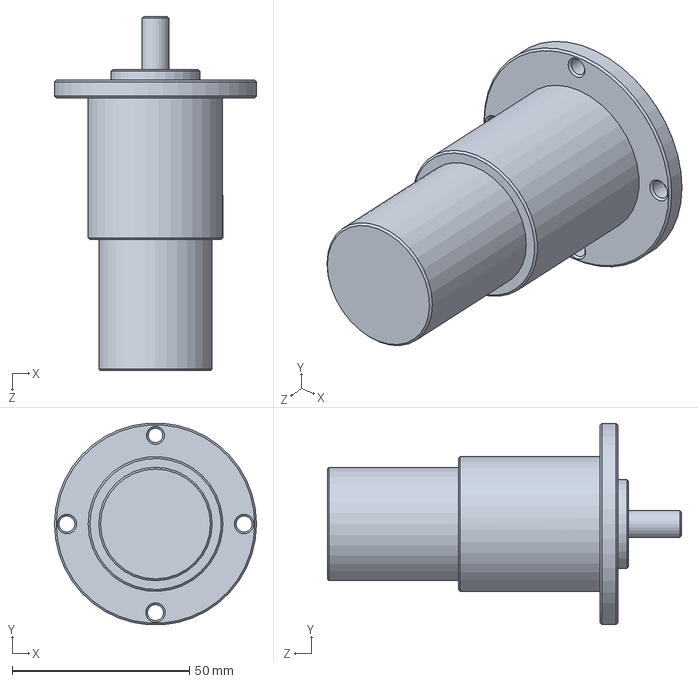
[picture p81: CAD file, 2013-02-24]
trunk/SolidWorks/Bouncebot/23 Rudder Roll Motor.SLDPRT
57.0 x 56.8 x 100.0 mm
