pratikac/islom/trunk/SolidWorks/Bouncebot/27 Stem Pivot Pin.SLDPRT

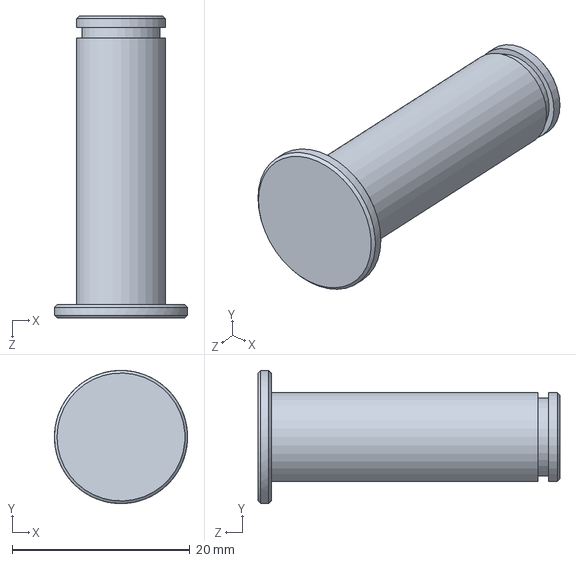
[picture p82: CAD file, 2013-02-24]
trunk/SolidWorks/Bouncebot/27 Stem Pivot Pin.SLDPRT
15.0 x 15.0 x 34.0 mm
