pratikac/islom/trunk/SolidWorks/Bouncebot/01 Stem.SLDPRT

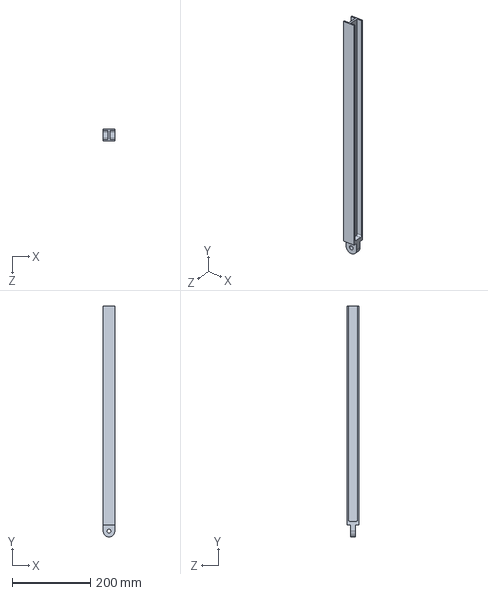
[picture p83: CAD file, 2013-02-24]
trunk/SolidWorks/Bouncebot/01 Stem.SLDPRT
30.0 x 590.0 x 30.0 mm
