pratikac/islom/trunk/SolidWorks/Bouncebot/18 Lock Roll Spacer.SLDPRT

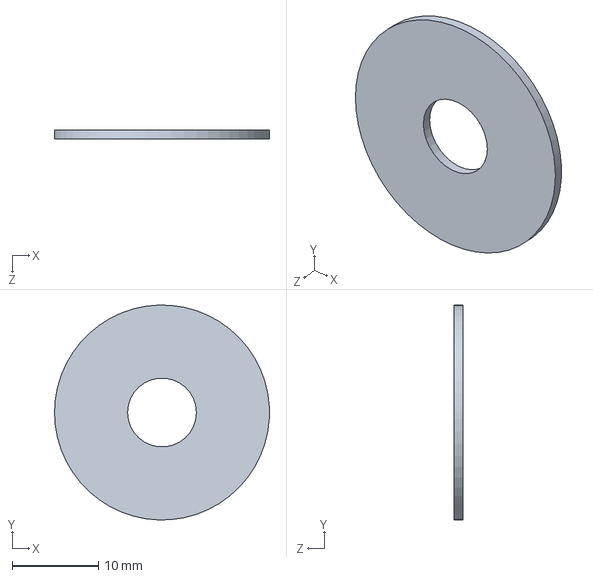
[picture p84: CAD file, 2013-02-24]
trunk/SolidWorks/Bouncebot/18 Lock Roll Spacer.SLDPRT
25.0 x 25.0 x 1.00 mm
