pratikac/islom/trunk/SolidWorks/Bouncebot/12 Swing Pin.SLDPRT

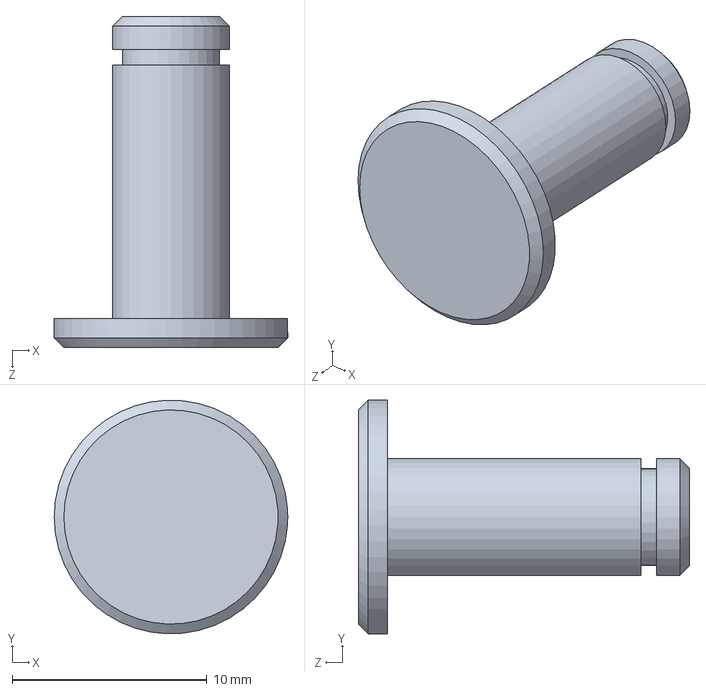
[picture p85: CAD file, 2013-02-24]
trunk/SolidWorks/Bouncebot/12 Swing Pin.SLDPRT
12.0 x 12.0 x 17.0 mm
