pratikac/islom/trunk/SolidWorks/Bouncebot/07 Pinion Spacer.SLDPRT

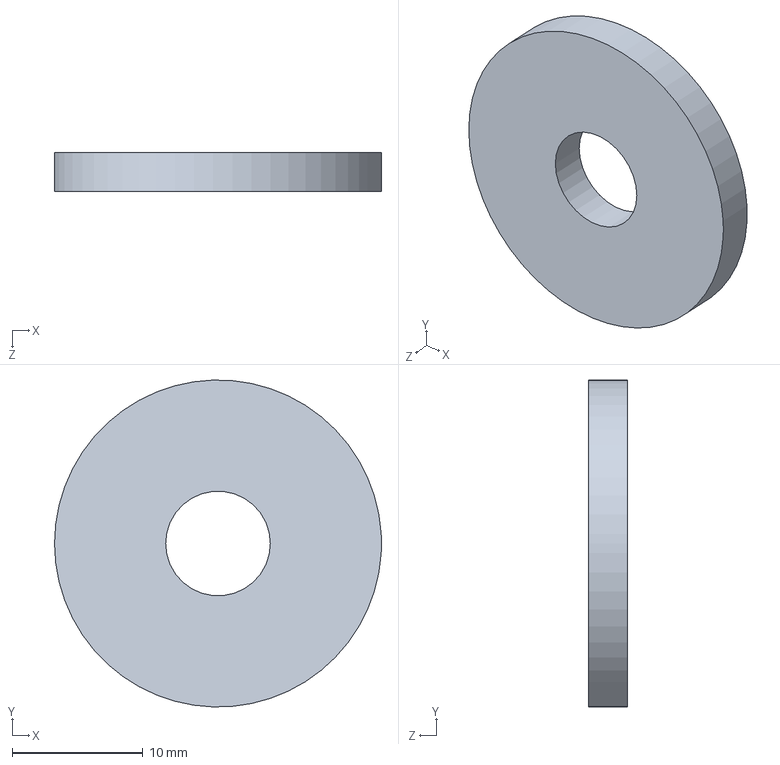
[picture p86: CAD file, 2013-02-24]
trunk/SolidWorks/Bouncebot/07 Pinion Spacer.SLDPRT
25.0 x 25.0 x 3.00 mm
