pratikac/islom/(list of files, cad)

Other CAD files:
trunk/SolidWorks/fab3/worm_wheel.SLDPRT
trunk/SolidWorks/fab3/flange1.SLDPRT
trunk/SolidWorks/Bouncebot/ratchet drawing.SLDPRT
trunk/SolidWorks/Bouncebot/Body.dwg
trunk/SolidWorks/Bouncebot/11 Swing Pin Washer.SLDPRT
