pratikac/islom/trunk/SolidWorks/front_assembly.png

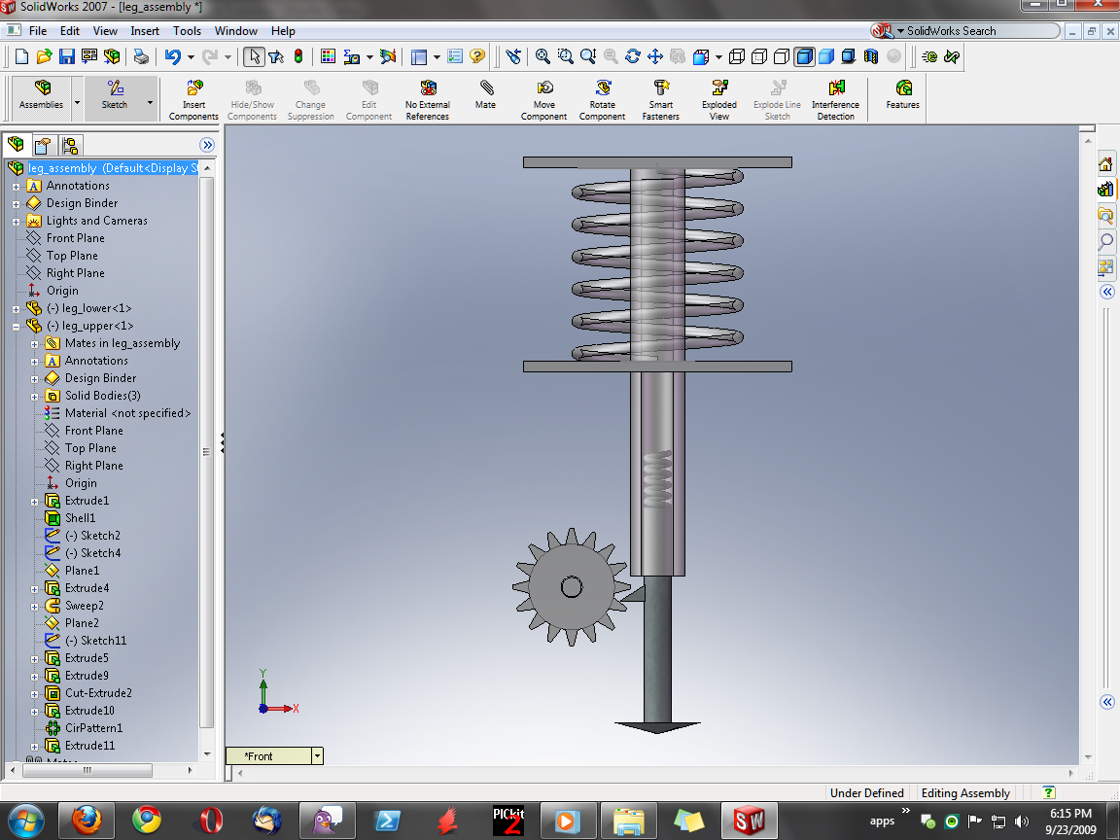
trunk/SolidWorks/front_assembly.png
