pratikac/islom/trunk/Doc/StageI/report/fig/ARLMono2_sch.pdf

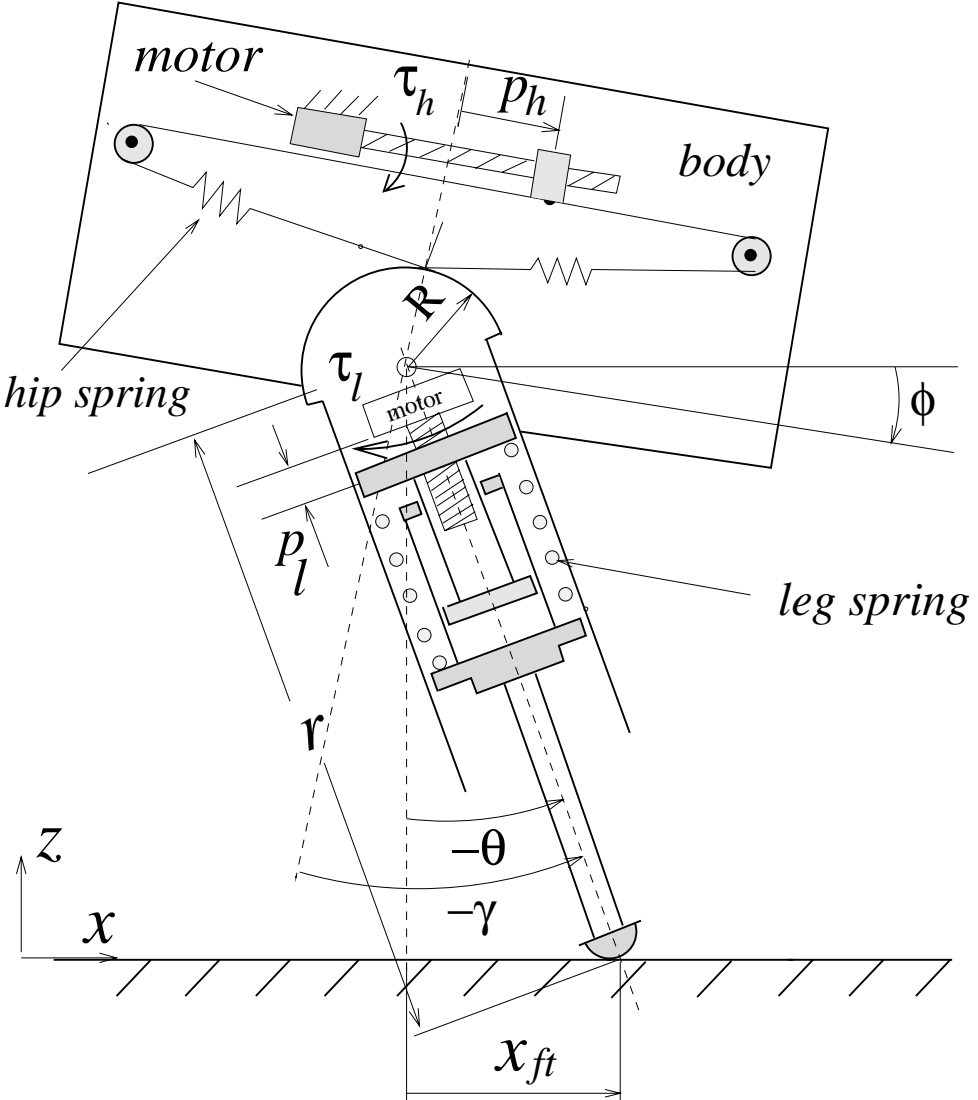
[picture p88: page 1]
body; motor; leg spring; hip spring
