pratikac/islom/trunk/Doc/StageII/report/fig/pSpringParams_perturb.pdf

## Params Spring

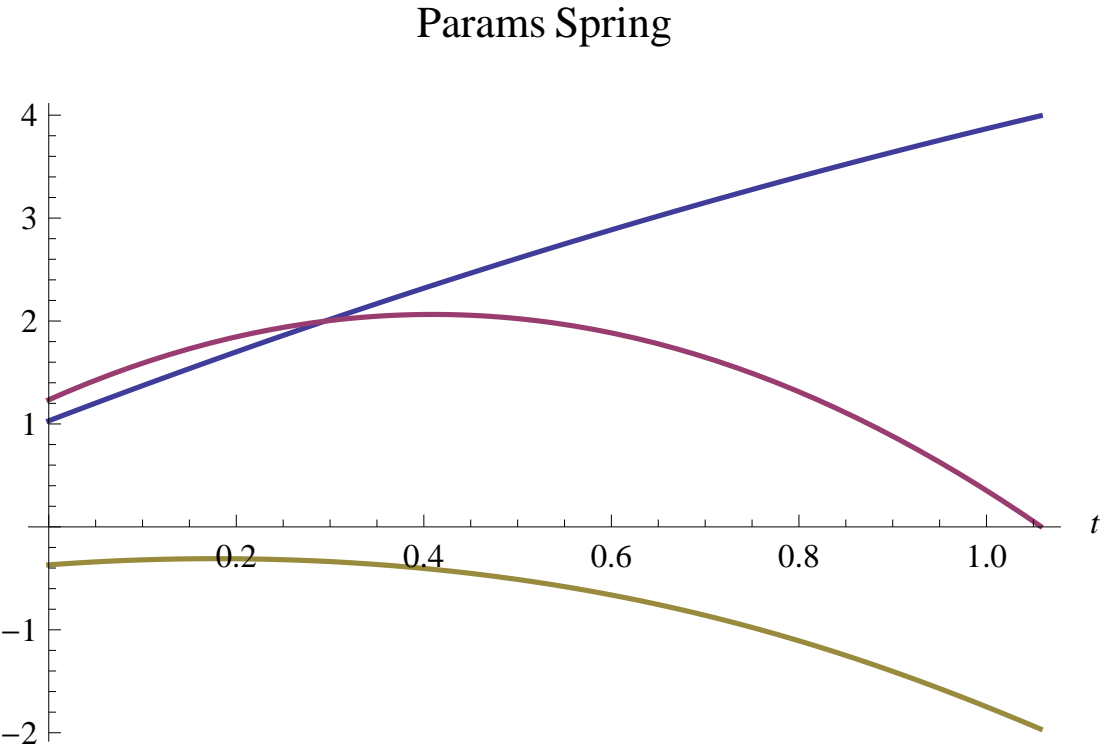
[picture p89: page 1]
