pratikac/islom/trunk/Doc/StageII/report/fig/pSpringParamsG.pdf

## Params Spring

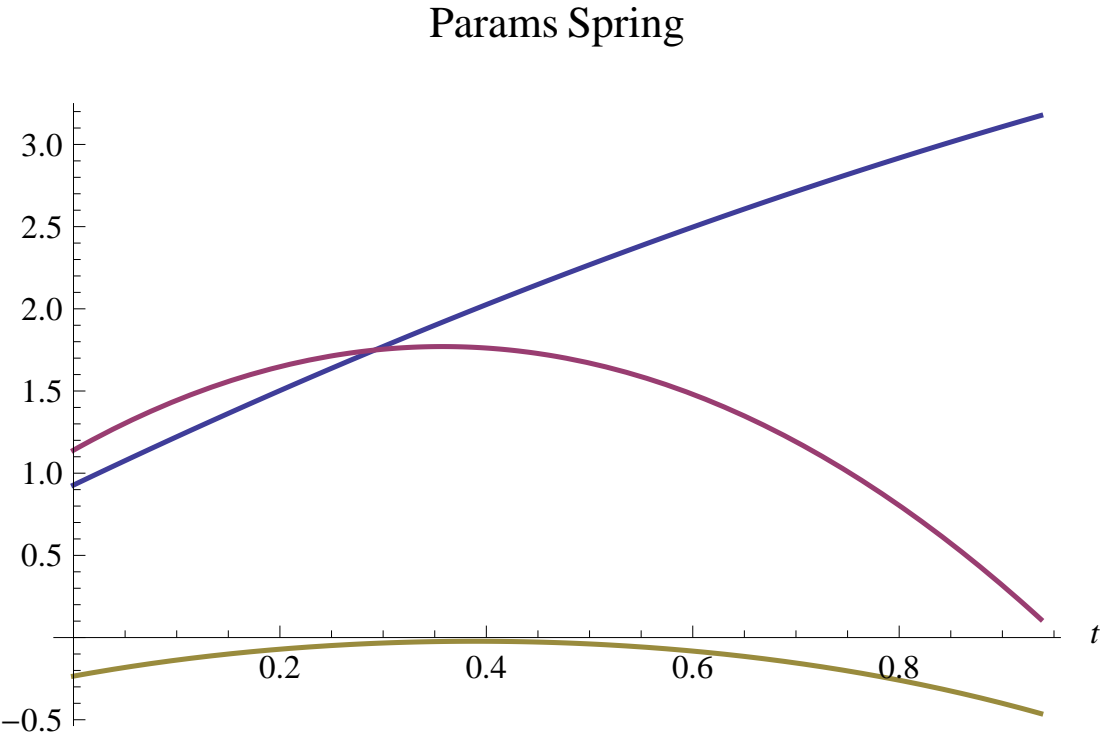
[picture p90: page 1]
