pratikac/islom/trunk/Doc/StageI/report/fig/kalman_lowfreq.pdf

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

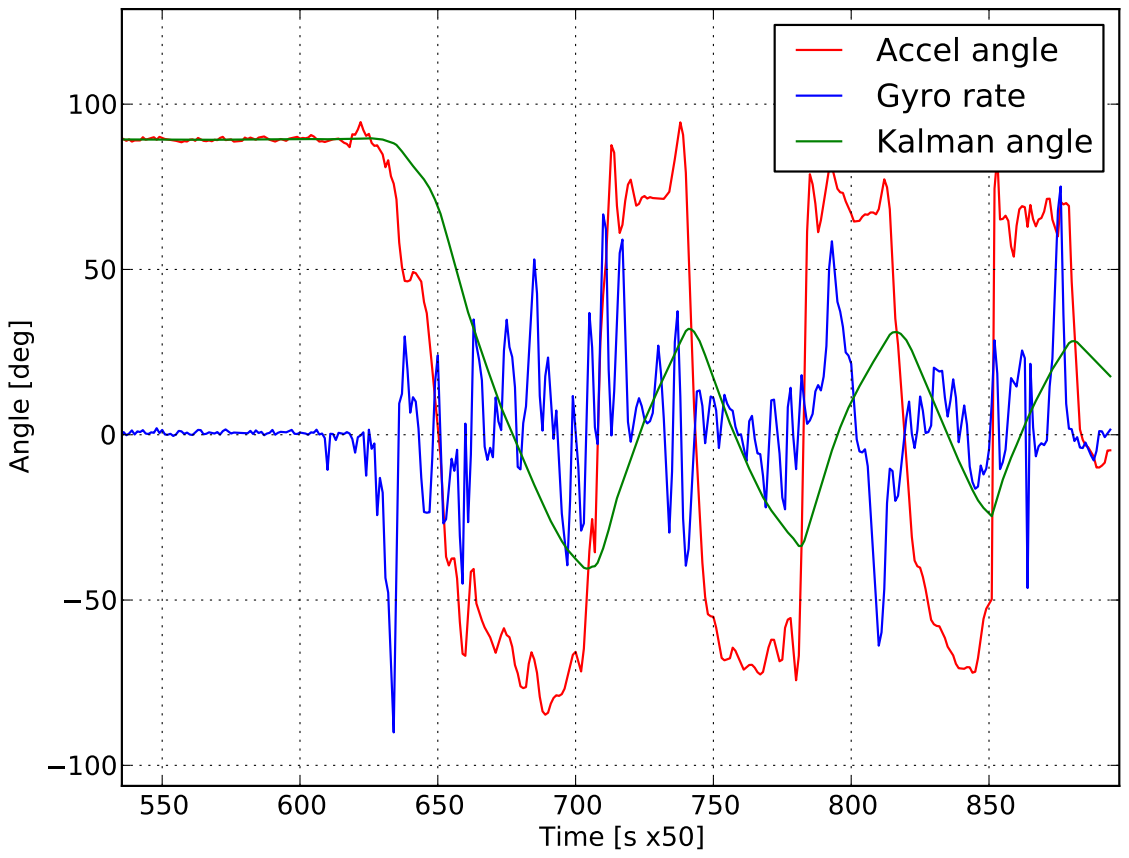
[picture p94: page 1]
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
