pratikac/islom/trunk/Doc/StageI/report/fig/rewac_dist.pdf

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

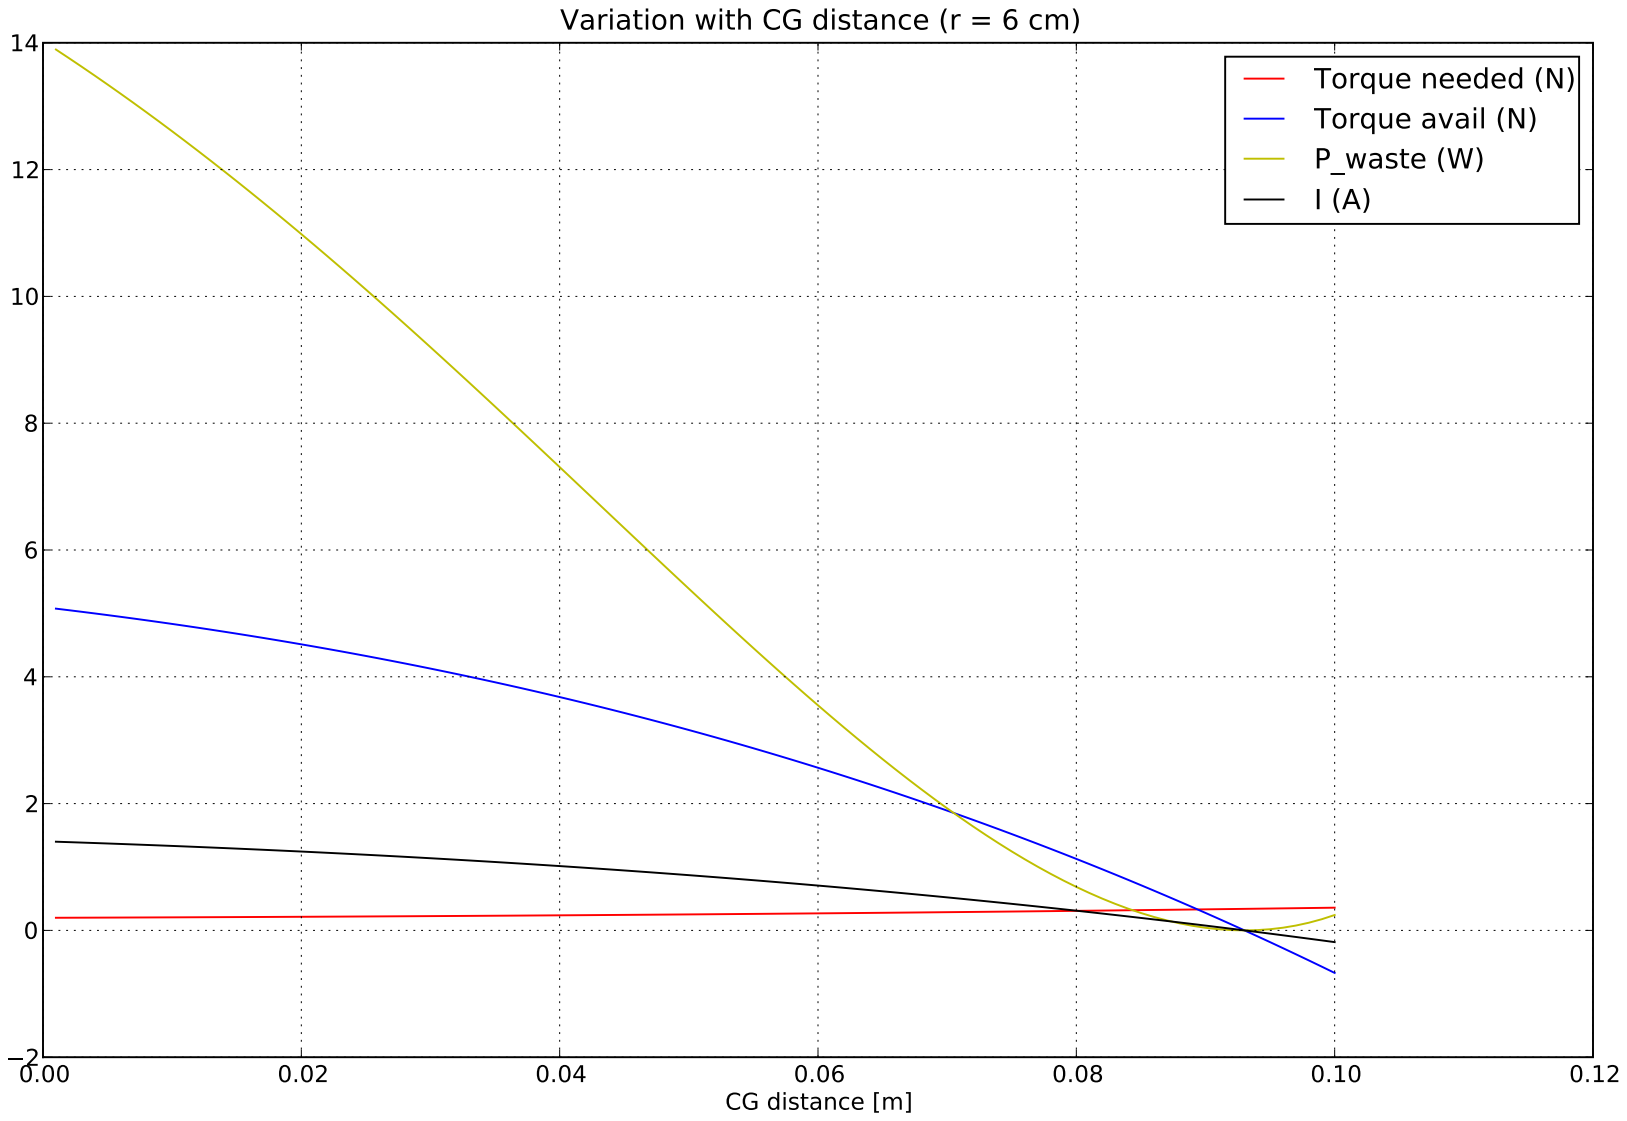
[picture p95: page 1]
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
