pratikac/islom/trunk/Doc/StageII/report/fig/design2.pdf

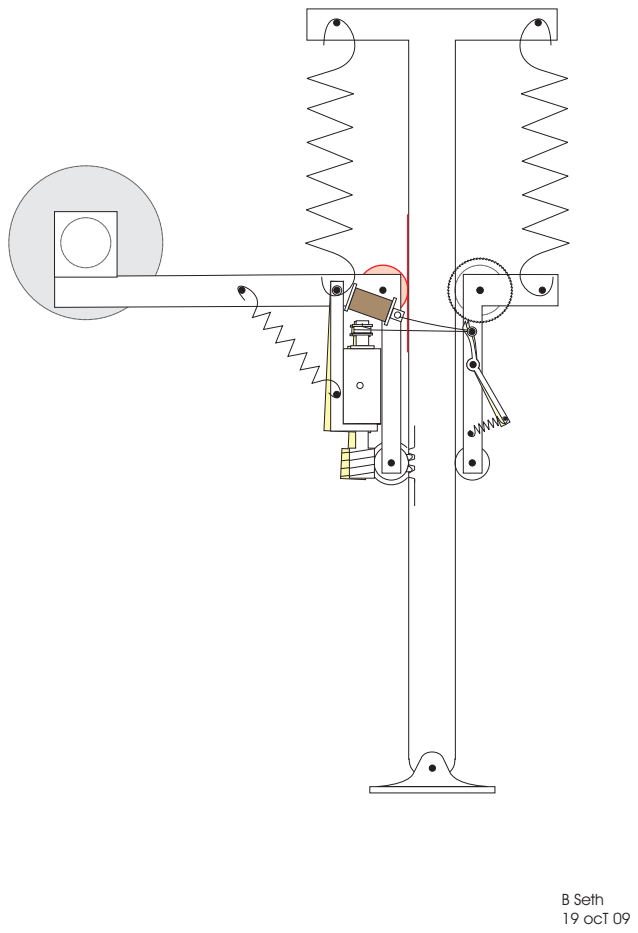
[picture p97: page 1]
B Seth; 19 ocT 09
