pratikac/islom/trunk/Doc/StageII/report/fig/inplace_pFlight_params.pdf

## Flight Params

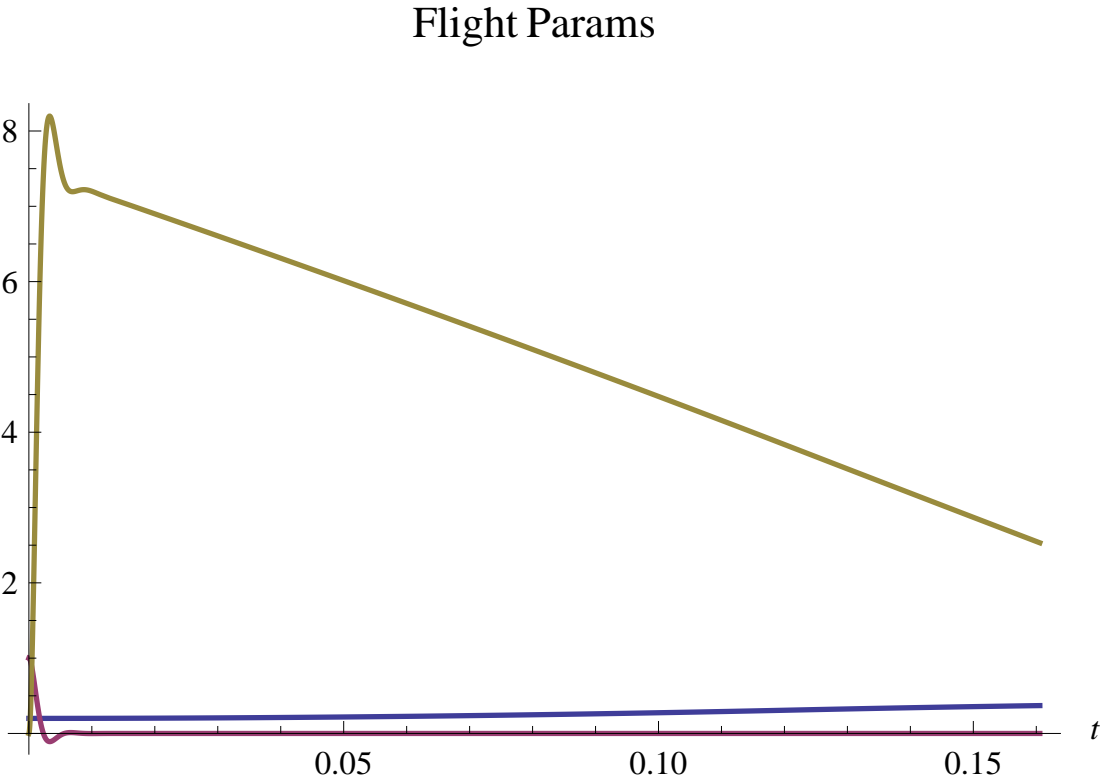
[picture p98: page 1]
