pratikac/islom/trunk/Doc/StageII/report/fig/inplace_pStance_params.pdf

## StanceParams

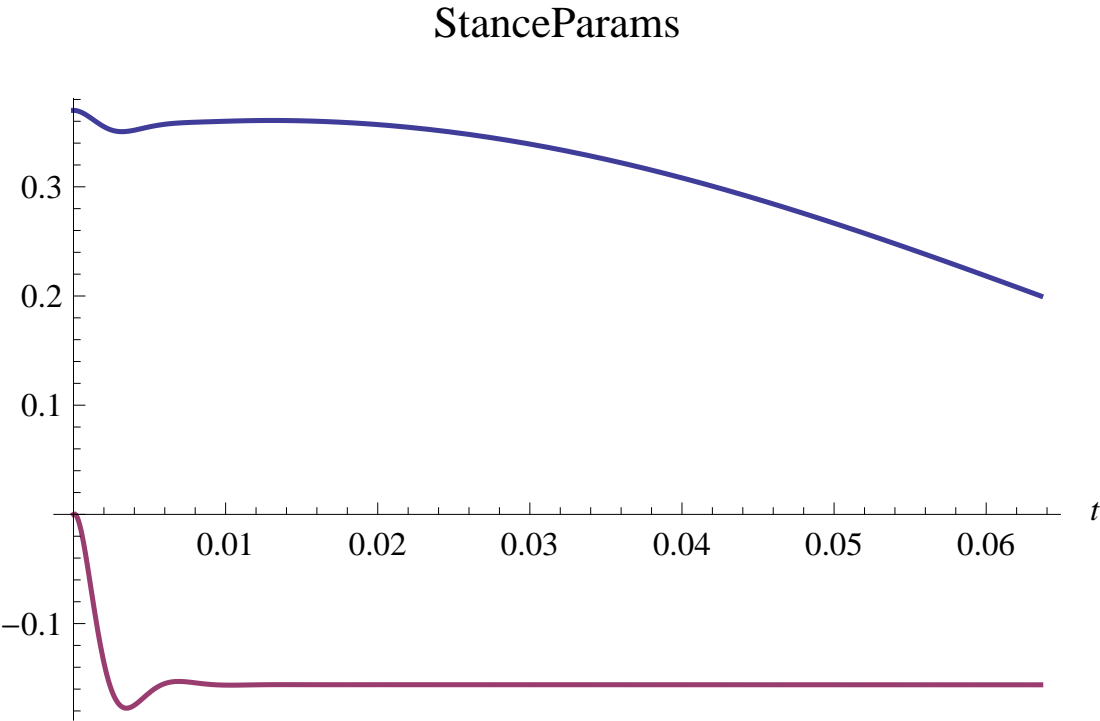
[picture p99: page 1]
