pratikac/islom/trunk/Doc/StageII/report/fig/kf_fp_lf.pdf

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

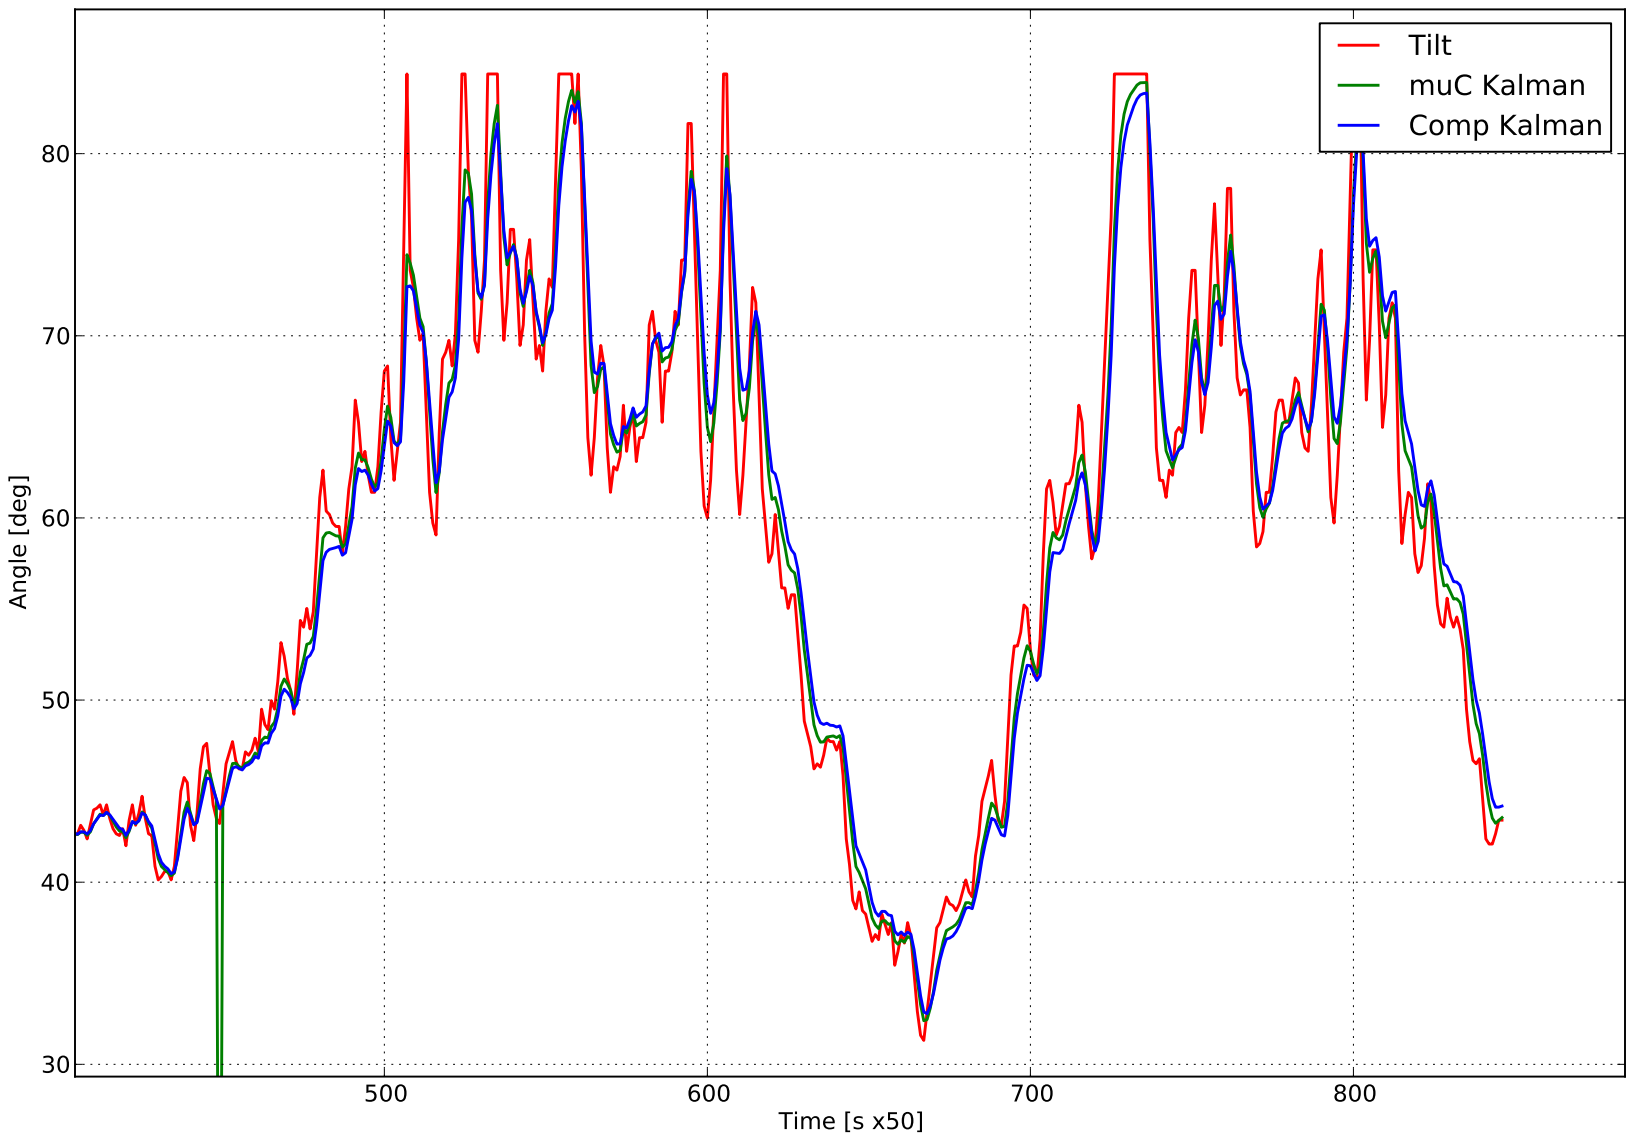
[picture p101: page 1]
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
