pratikac/islom/trunk/Doc/StageII/report/fig/pFullTrajec_control.pdf

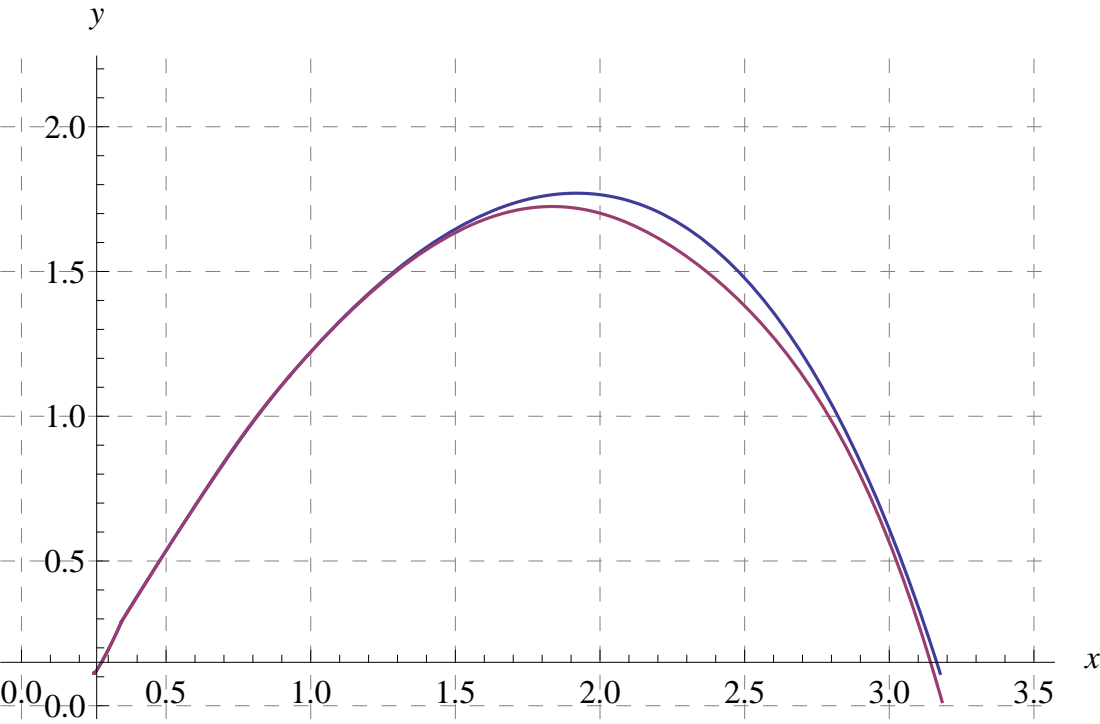
[picture p102: page 1]
