pratikac/islom/trunk/Doc/StageII/report/fig/plot_inplace.pdf

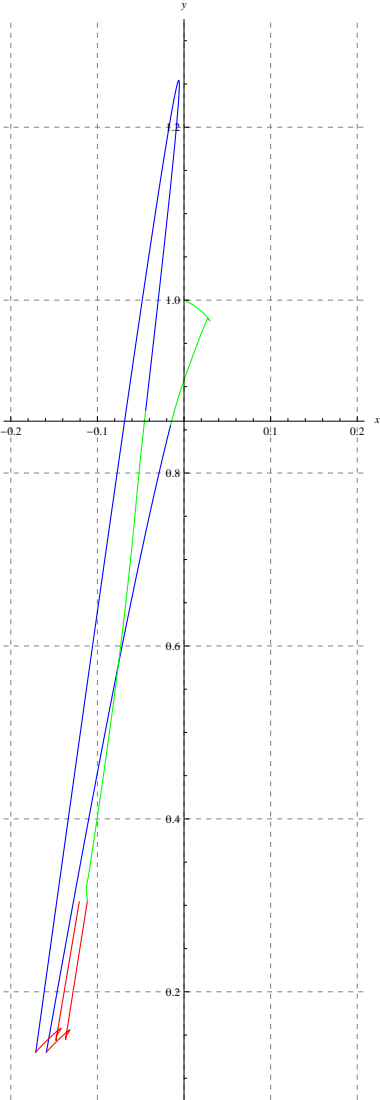
[picture p103: page 1]
