pratikac/islom/trunk/Doc/StageII/report/fig/plot_perturb.pdf

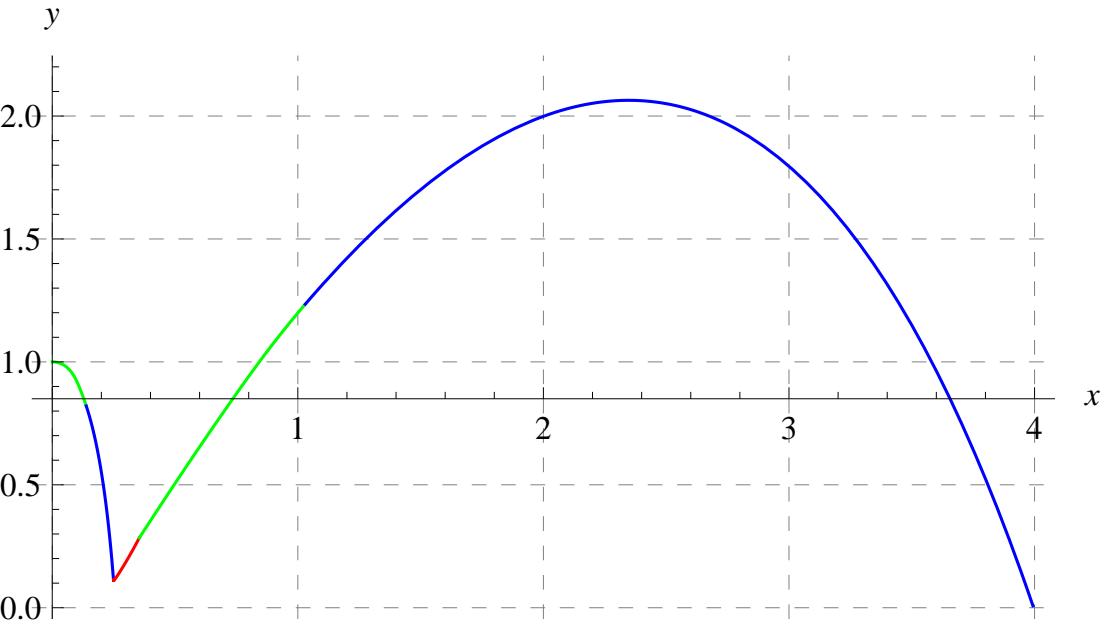
[picture p104: page 1]
