pratikac/islom/trunk/Doc/StageII/report/fig/plotG.pdf

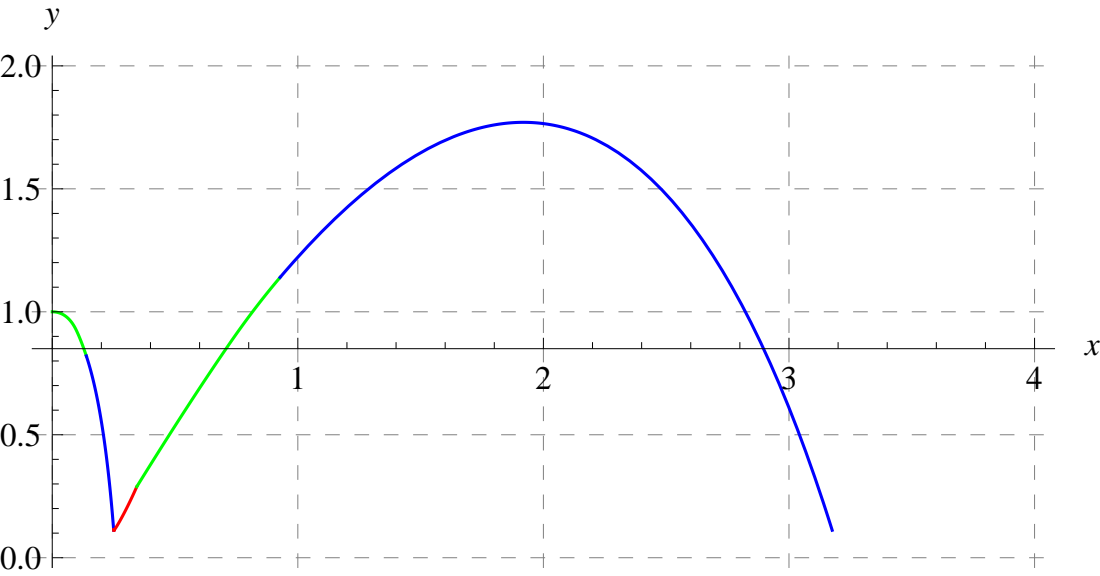
[picture p105: page 1]
