pratikac/islom/trunk/Doc/StageII/report/fig/pStance_params_control.pdf

## StanceParams

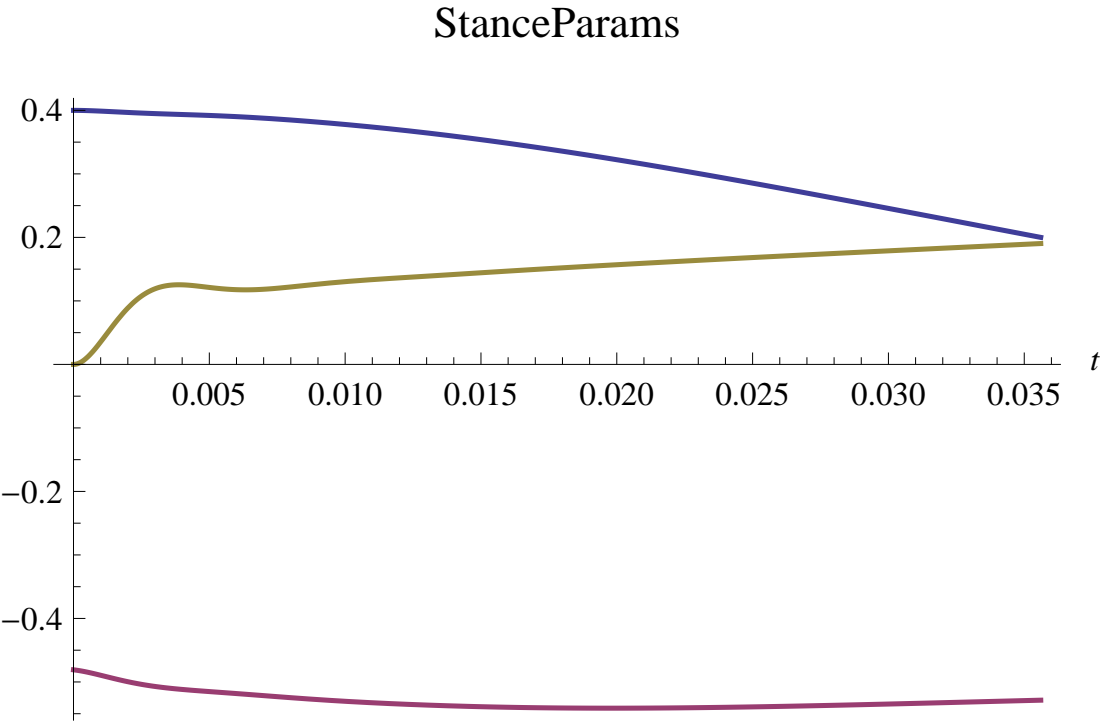
[picture p106: page 1]
