pratikac/islom/trunk/Doc/StageII/report/fig/pStance_trajec_control.pdf

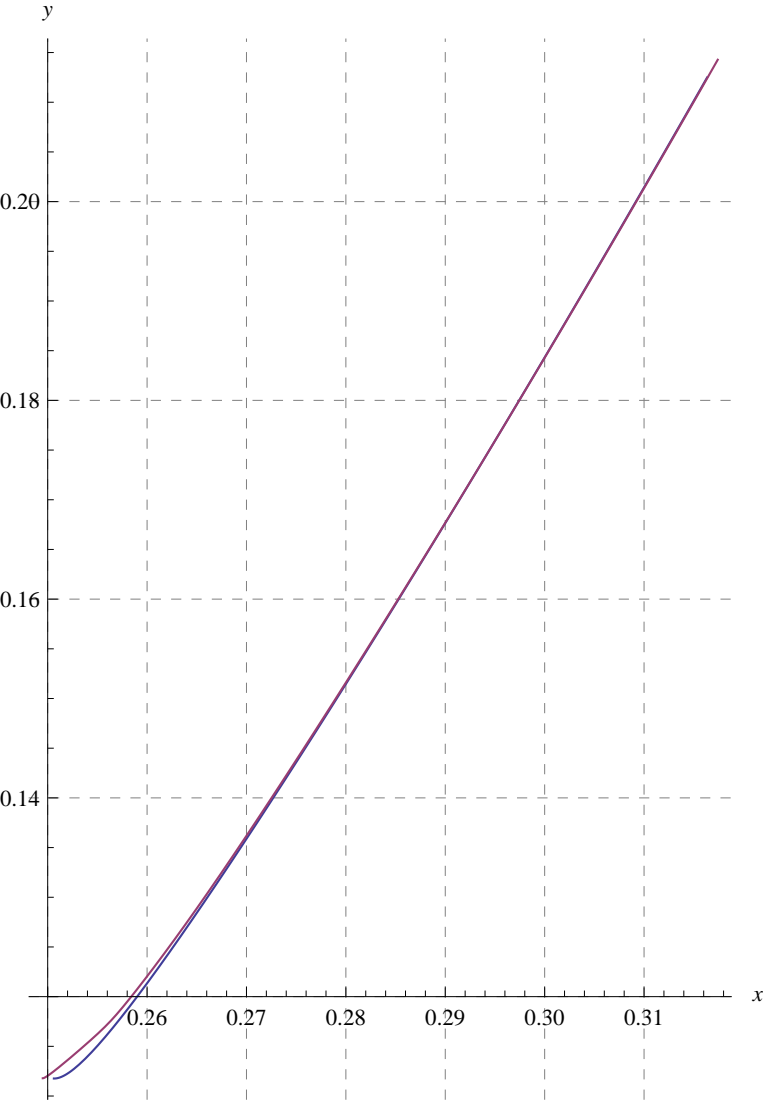
[picture p107: page 1]
