pratikac/islom/trunk/Doc/StageII/report/fig/rewac_bot.pdf

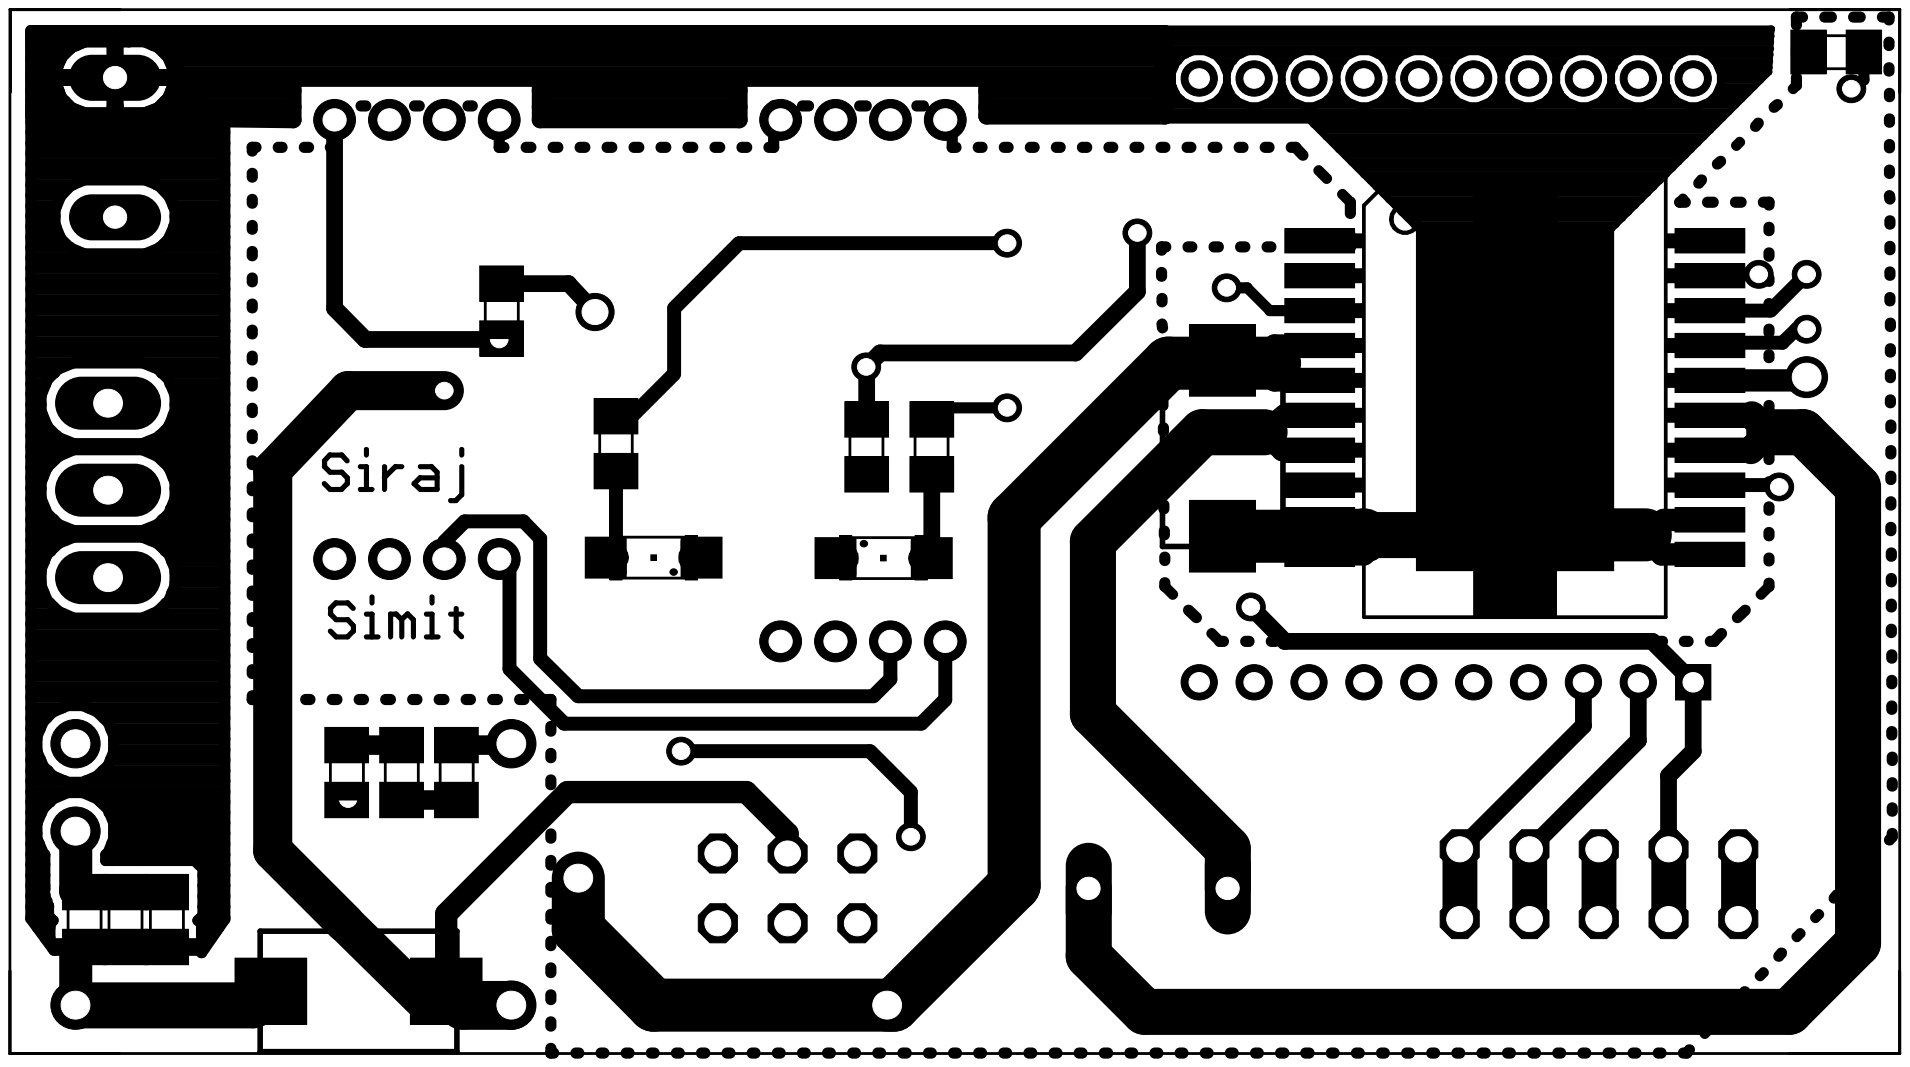
[picture p108: page 1]
