pratikac/islom/trunk/Doc/StageII/report/fig/rewac_top.pdf

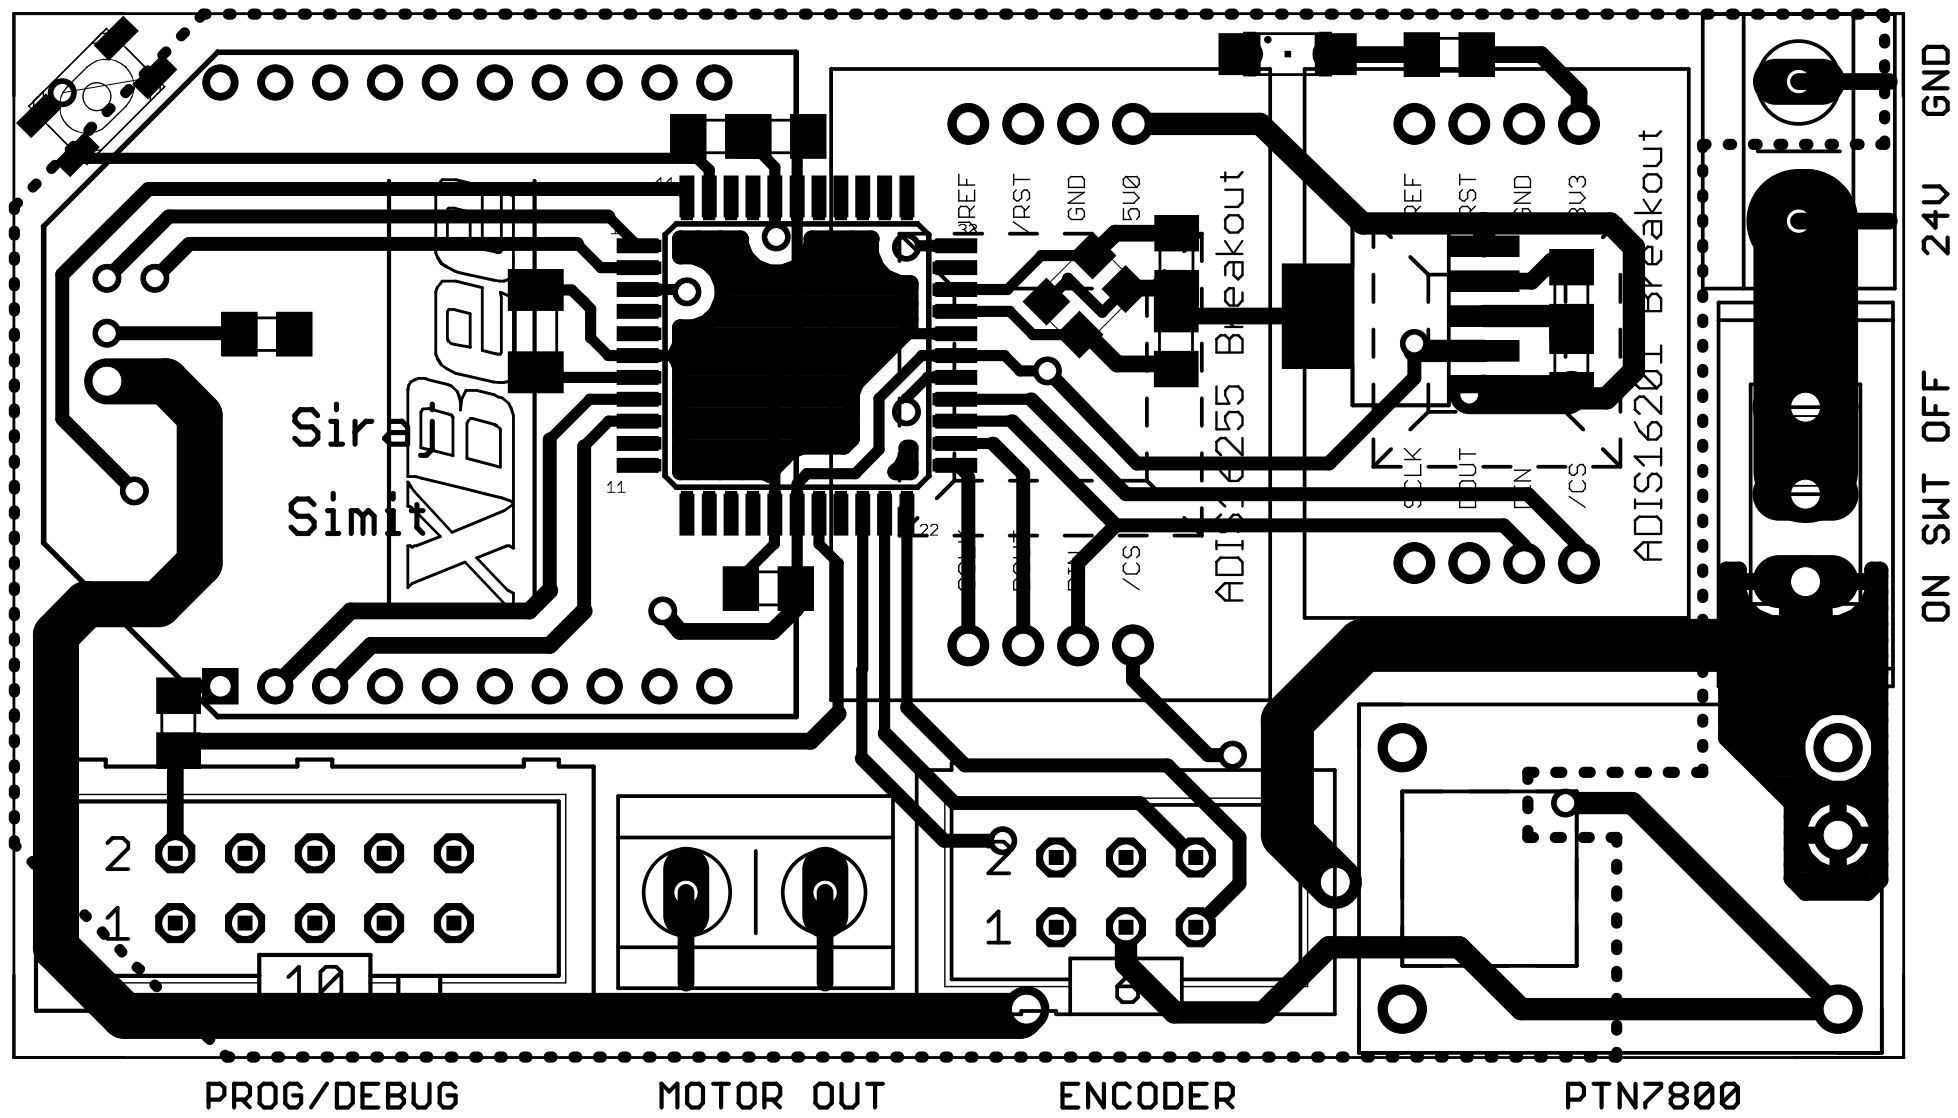
[picture p109: page 1]
