pratikac/islom/(commit log)

2009-10-02 Initial import
    [leg_assembly.SLDASM, leg_lower.SLDPRT, leg_upper.SLDPRT]
2009-10-02 Kalman filter
    4 data sets, implement Kalman filter from sparkfun code
    Constants are not tuned
    Timer interrupt added at 50 Hz
2009-10-18 Adds rewac simulation
    Corrected formula for available torque in 2mass.py
2009-10-26 Velocity control in motor_project
    Pre-extension added in simulation for rewac and freq
2009-10-28 3 chapters finished in report
    Correct covariances in Kalman sim
    [main.c, plot.py]
2009-11-13 Finished presentation Stage I
2009-11-27 Fab design iter1
    [fab_leg.SLDPRT]
2009-11-27 PID velocity control of motor
2009-12-15 Windows repo pain after mobo
    [main.brd]
2010-01-26 Floating point KF
    Fab3, Eagle lib, main board sch, hbridge board
    [band_drive.SLDPRT, flange1.SLDPRT, flange2.SLDPRT, hbridge.brd, hbridge.sch, leg.SLDPRT, main.brd, main.sch]
2010-02-04 Eagle lib for TUSB
    [drv8801.brd, drv8801.sch, hbridge.brd, order1.brd]
2010-02-26 mathematica simulation added
    [drv8801.brd, hbridge.brd, hbridge.sch]
2010-03-17 Bouncebot added
    [01 Stem.SLDPRT, 02 Rack.SLDPRT, 03 Swing.SLDPRT, 04 Swing Motor.SLDPRT, 05 Swing Motor Gear.SLDPRT, 06 Helical Pinion.SLDPRT, 07 Pinion Spacer.SLDPRT, 08 Pinion Axle.SLDPRT]
2010-03-23 all stages completed, stiffness problem at the topmost point
2010-11-04 Commit for stageII documentation
2010-11-04 Add StageII/pres
2010-11-04 Adds StageII/report
